RepRapLtd/FrankTheRobot/README.md

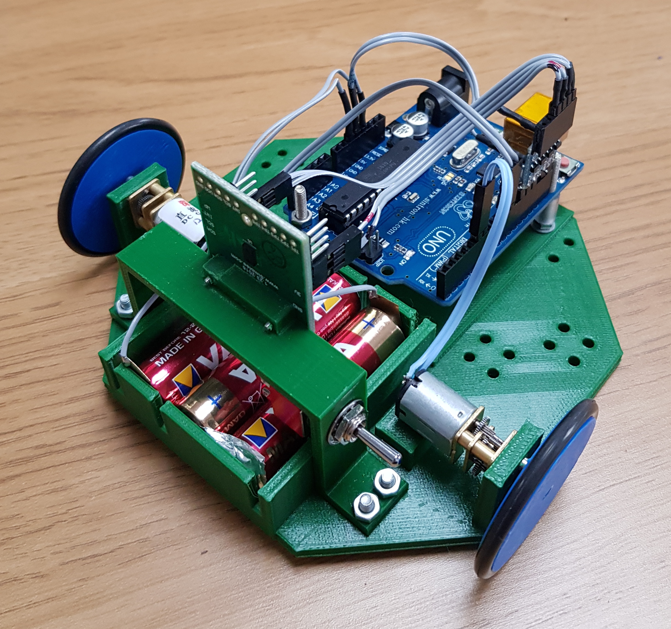
[picture p1: Pictures/frank.jpg]
Frank The Robot


This is a small robot for testing out LIDAR scanning rangefinders, automatic environment mapping, 21st century Grey-Walter tortoise like behaviour etc.
