RepRapLtd/FrankTheRobot/Electronics/pinouts.ods

GPIO 0 | ground to program
GPIO 2 | 10K pullup
GPIO 15 | 10K pulldown
 | Frank | D1 MINI | D1 MINI
 | A select | D0 | GPIO 16
 | SCL (LIDAR) | D1 | GPIO 5
 | SDA (LIDAR) | D2 | GPIO 4
 | right FIN | D3 | GPIO 0*
 | right RIN | D4 | GPIO 2*
 | left FIN | D8 | GPIO 15*
 | left RIN | D6 | GPIO 12
 | right SENSE | D7 | GPIO 13
 | left SENSE | D5 | GPIO 14
 | Analog in | A0 | ADC
