RepRapLtd/FrankTheRobot/Frank 2.0/Electronics/board-back.png

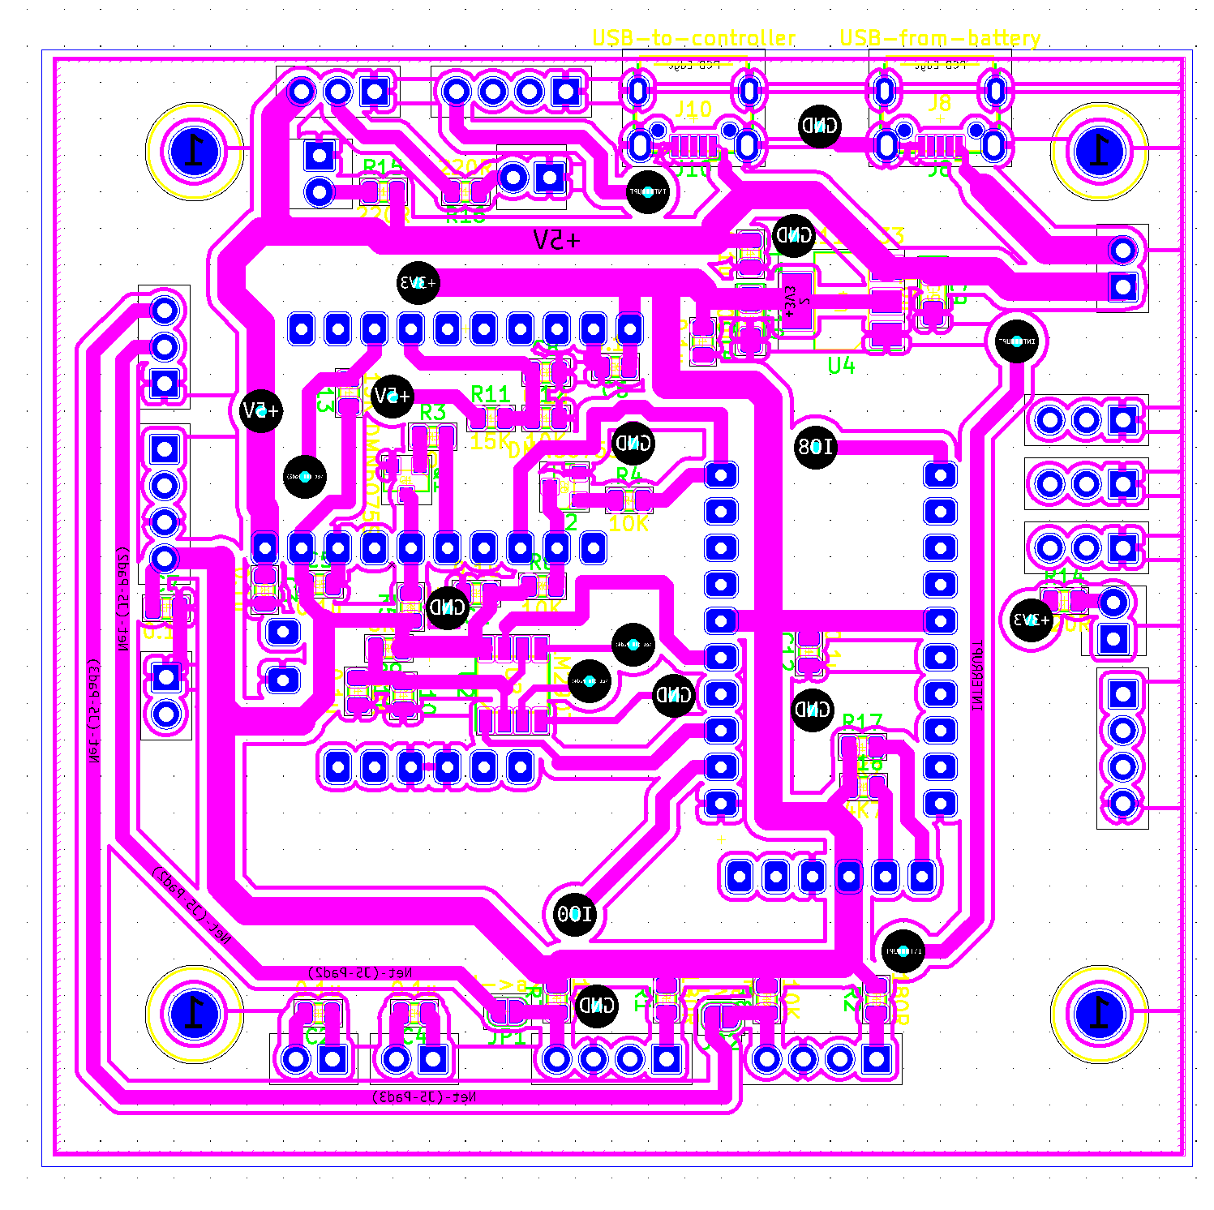
Frank 2.0/Electronics/board-back.png
