RepRapLtd/FrankTheRobot/Frank 2.0/Electronics/GPIO-Pinout-Diagram-2.png

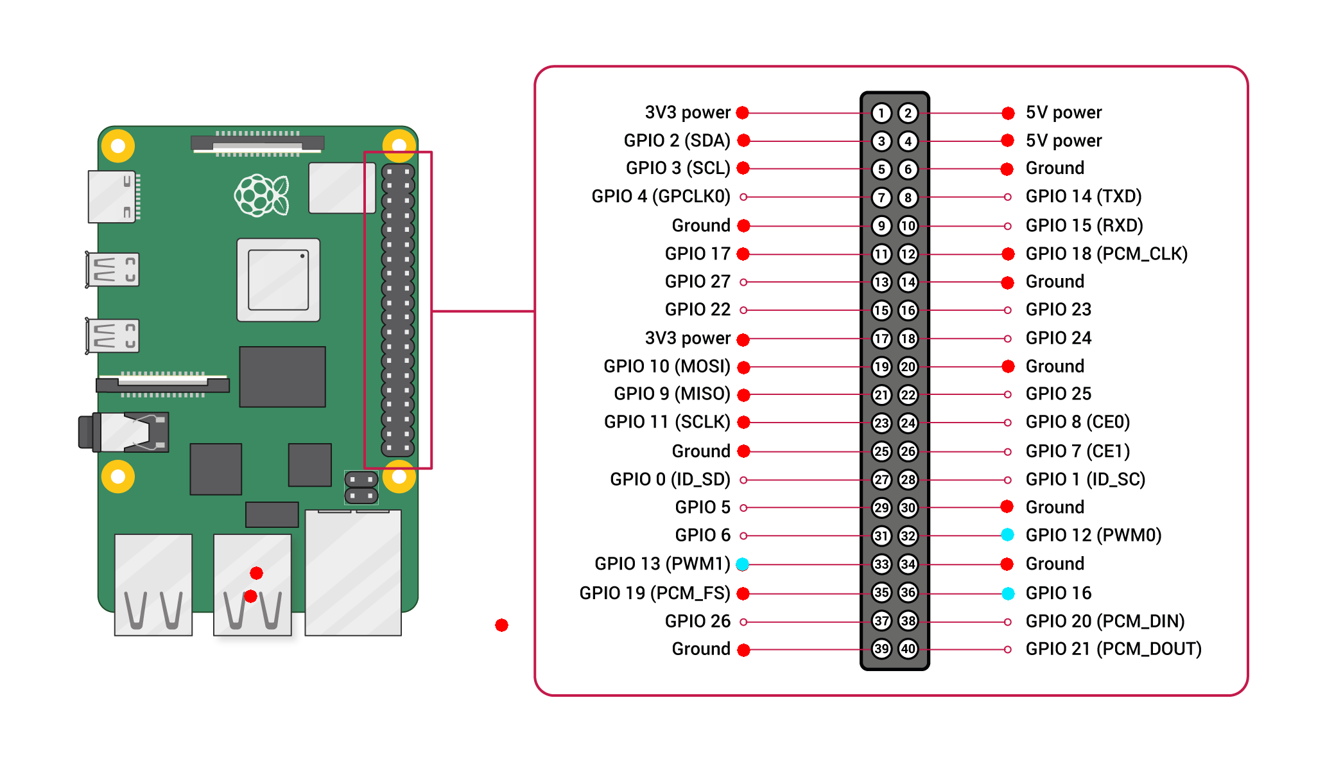
Frank 2.0/Electronics/GPIO-Pinout-Diagram-2.png
