RepRapLtd/FrankTheRobot/Frank 2.0/Electronics/schematic.png

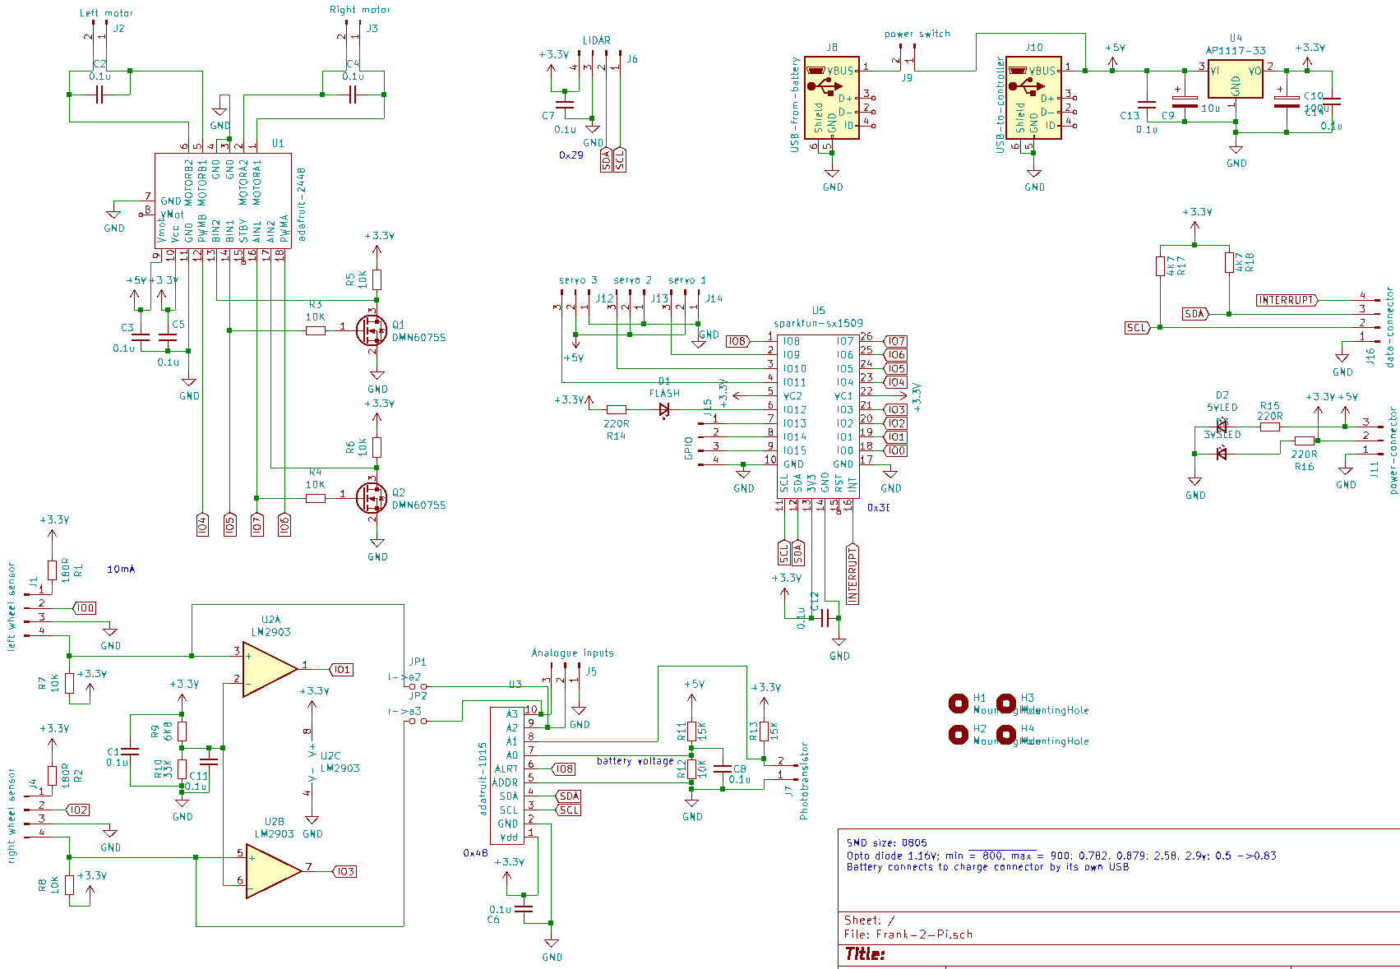
Frank 2.0/Electronics/schematic.png
