RepRapLtd/FrankTheRobot/Mechanics/STLs/5028.4 Frank Main Body.stl

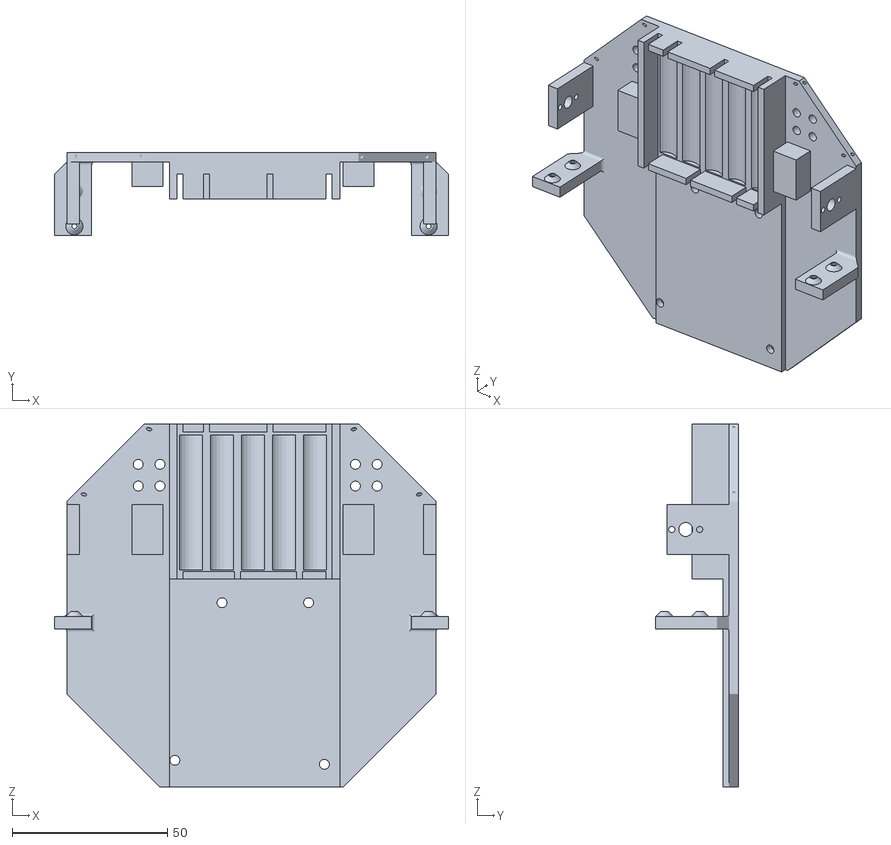
[picture p6: CAD file, 2018-05-11]
Mechanics/STLs/5028.4 Frank Main Body.stl
127.0 x 26.8 x 117.0
