RepRapLtd/FrankTheRobot/Mechanics/STLs/5028.2 Main body.stl

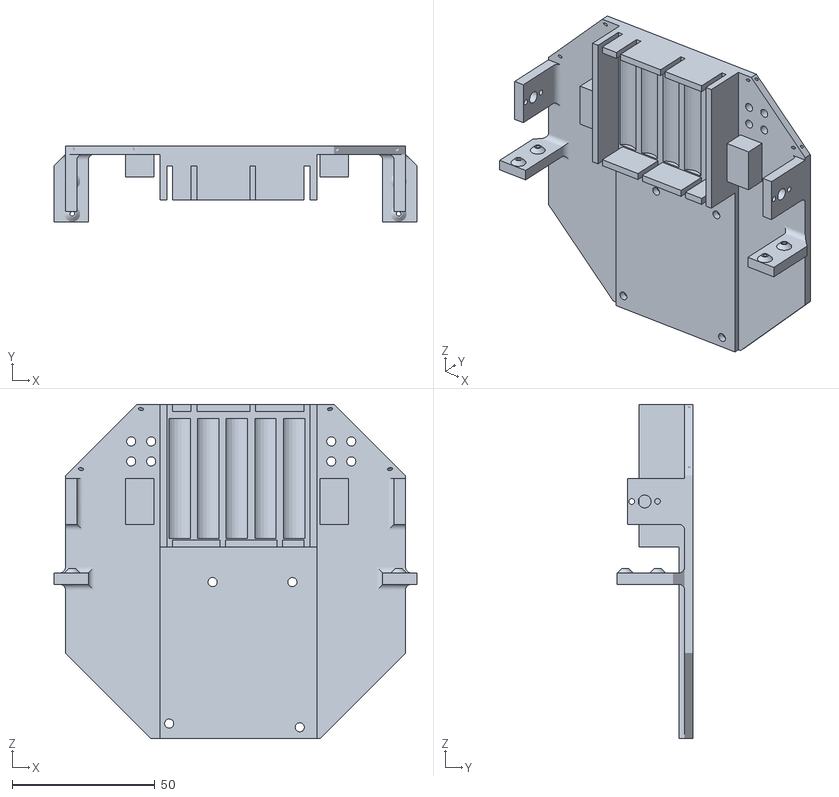
[picture p7: CAD file, 2018-02-01]
Mechanics/STLs/5028.2 Main body.stl
127.0 x 26.8 x 117.0
