RepRapLtd/FrankTheRobot/Frank 2.0/Mechanics/Battery Charge Indicator Clip.FCStd

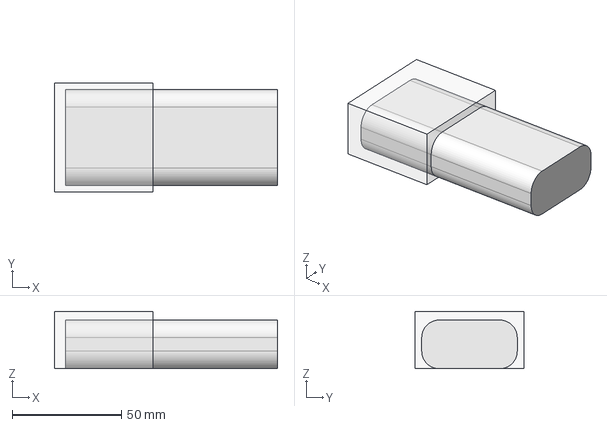
[picture p8: CAD file, 2021-03-25]
Frank 2.0/Mechanics/Battery Charge Indicator Clip.FCStd
102.0 x 50.0 x 26.3 mm
