RepRapLtd/FrankTheRobot/Mechanics/5028.7 Frank.fcstd

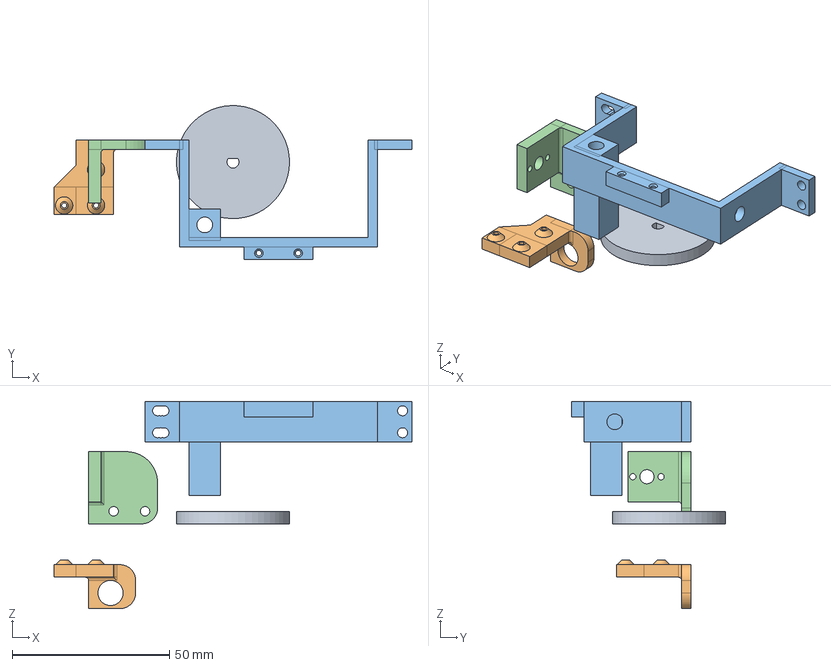
[picture p9: CAD file, 2020-05-19]
Mechanics/5028.7 Frank.fcstd
114.0 x 49.0 x 66.0 mm
Wheel Sensor Mount
Switch Mount
Motor Mount
