RepRapLtd/FrankTheRobot/Mechanics/STLs/5029.8 Power Dock Mount.stl

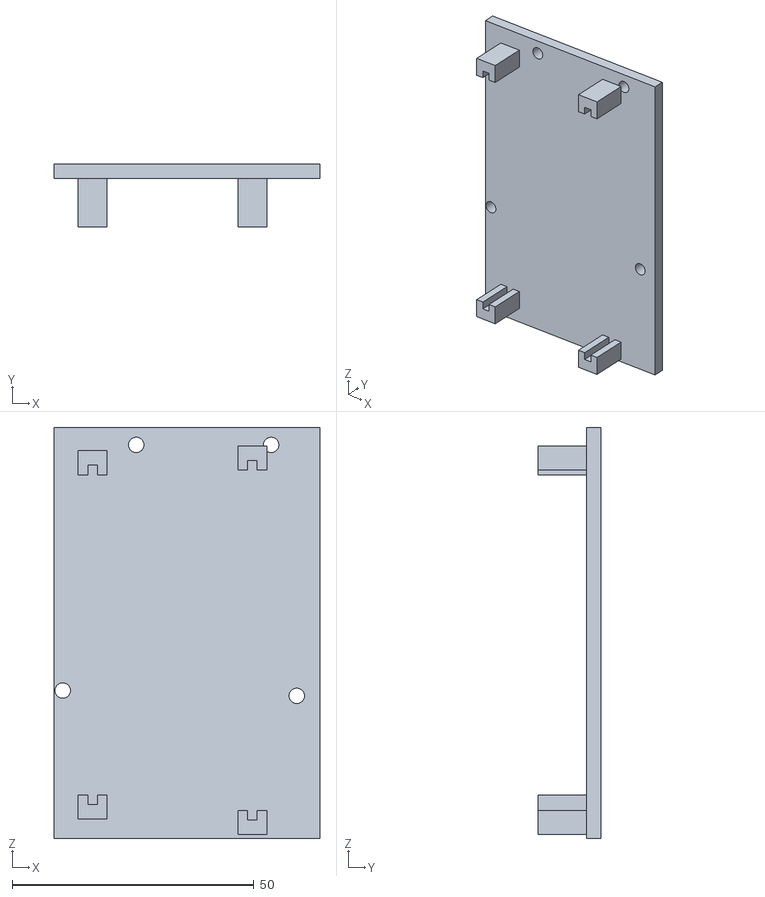
[picture p10: CAD file, 2020-05-19]
Mechanics/STLs/5029.8 Power Dock Mount.stl
55.0 x 13.0 x 85.0
