RepRapLtd/FrankTheRobot/Frank 2.0/Mechanics/Motor and Opto Sensor Mount0.5.FCStd

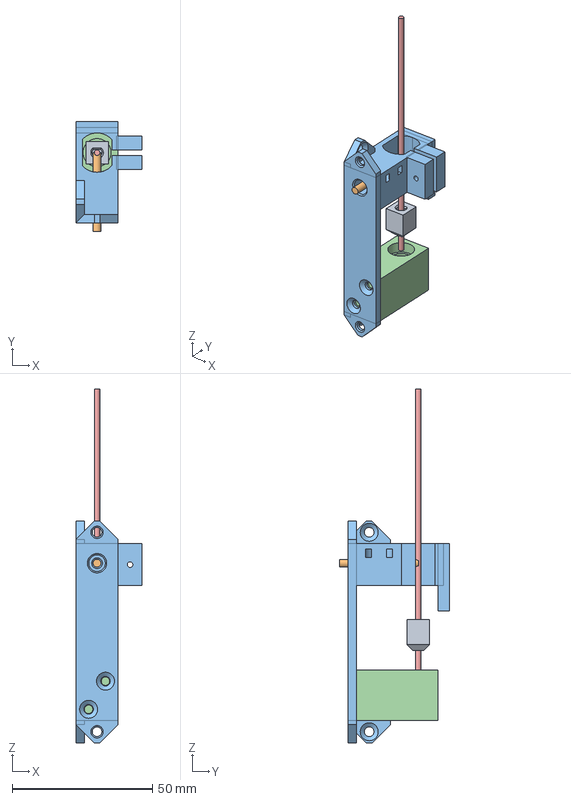
[picture p11: CAD file, 2020-09-02]
Frank 2.0/Mechanics/Motor and Opto Sensor Mount0.5.FCStd
23.5 x 39.0 x 126.0 mm
Square Peg 0.3
Motor and Opto Sensor Mount 0.4
Bearing Mount End 0.5
