RepRapLtd/FrankTheRobot/Mechanics/5029.8 Frank Power Dock .fcstd

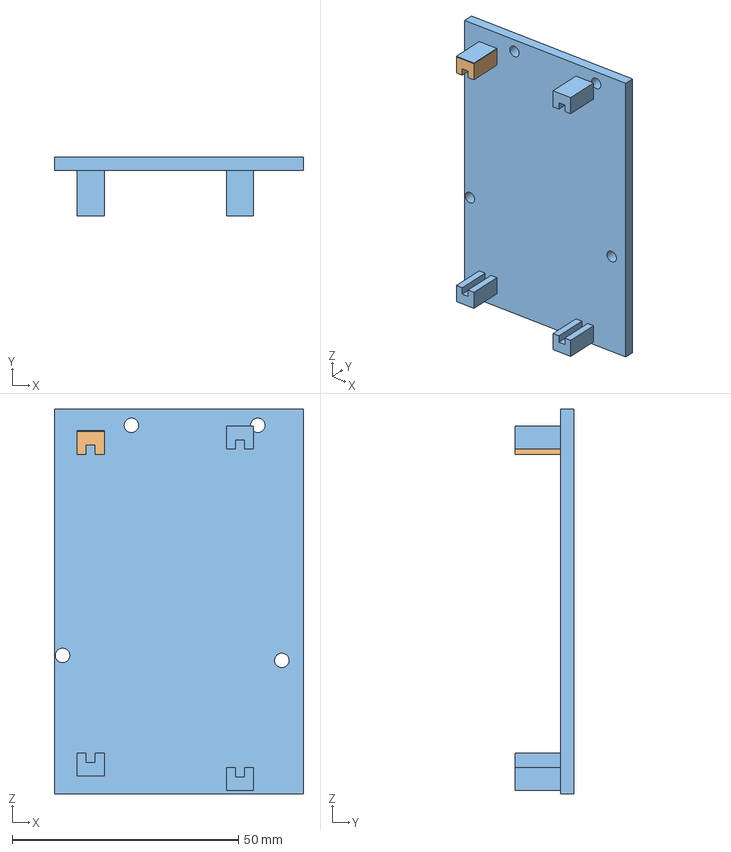
[picture p12: CAD file, 2020-05-19]
Mechanics/5029.8 Frank Power Dock .fcstd
55.0 x 13.0 x 85.0 mm
