RepRapLtd/FrankTheRobot/Mechanics/STLs/Wheel1.57 2019.stl

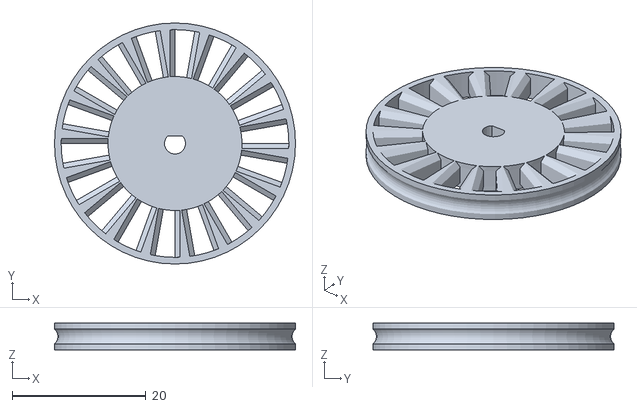
[picture p13: CAD file, 2020-05-19]
Mechanics/STLs/Wheel1.57 2019.stl
36.0 x 36.0 x 4.00
