RepRapLtd/FrankTheRobot/Frank 2.0/Mechanics/Square Peg 0.3.stl

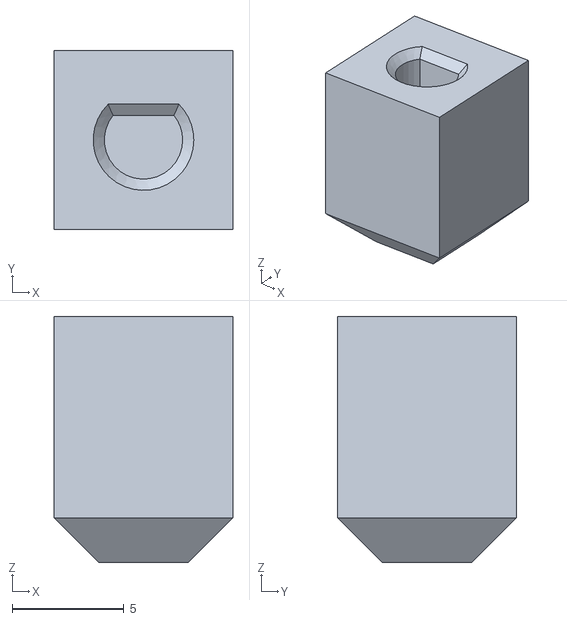
[picture p14: CAD file, 2020-09-02]
Frank 2.0/Mechanics/Square Peg 0.3.stl
8.00 x 8.00 x 11.0
