RepRapLtd/FrankTheRobot/Mechanics/STLs/5028.7 Wheel Sensor Mount.stl

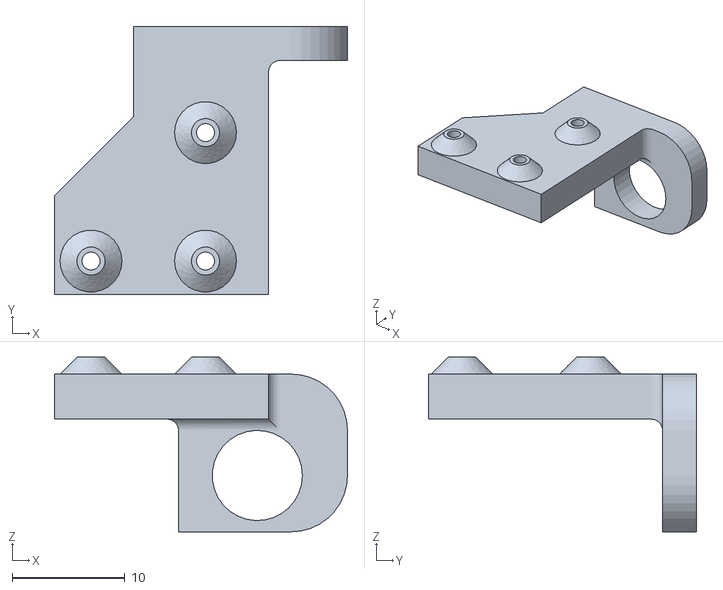
[picture p15: CAD file, 2019-01-25]
Mechanics/STLs/5028.7 Wheel Sensor Mount.stl
26.0 x 23.8 x 15.5
