RepRapLtd/FrankTheRobot/Frank 2.0/Mechanics/Bearing Mount End 0.5.stl

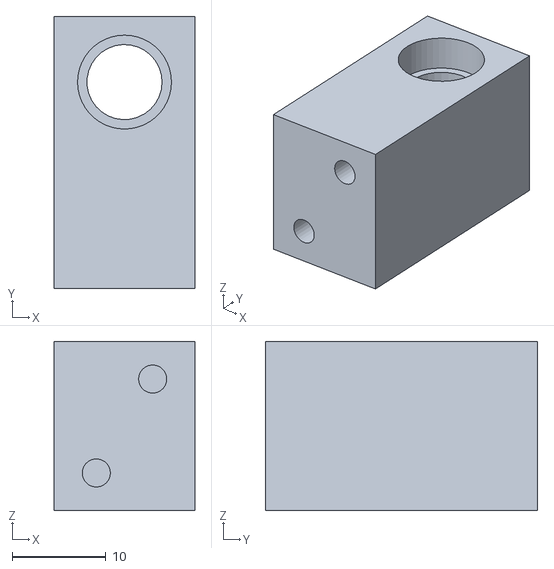
[picture p16: CAD file, 2020-08-12]
Frank 2.0/Mechanics/Bearing Mount End 0.5.stl
15.0 x 29.0 x 18.0
