RepRapLtd/FrankTheRobot/Mechanics/5028.7 Blank Frank.fcstd

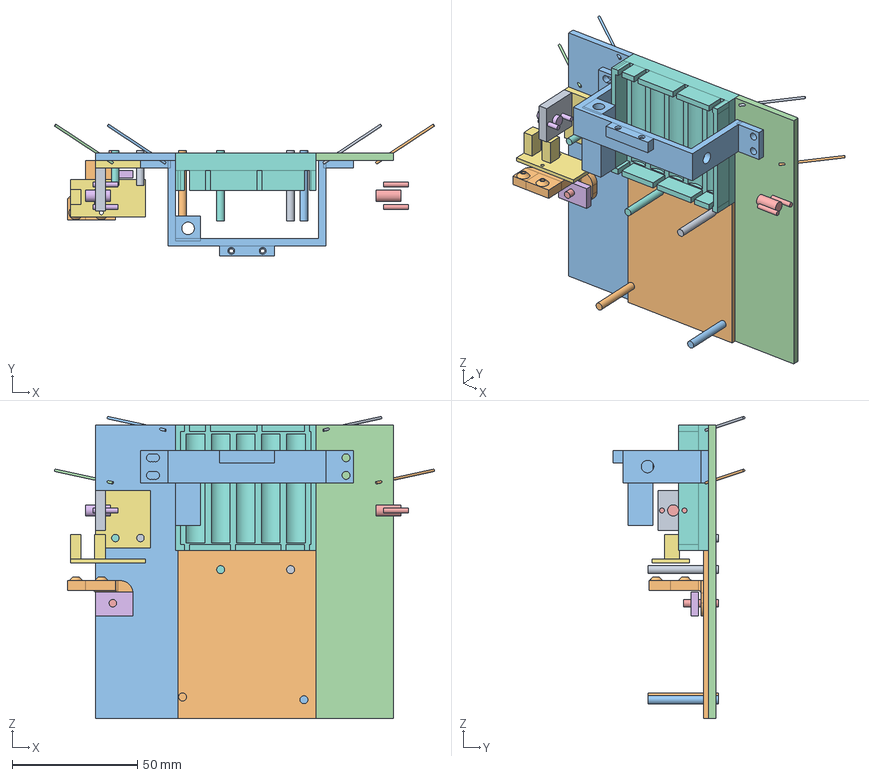
[picture p17: CAD file, 2018-06-24]
Mechanics/5028.7 Blank Frank.fcstd
151.6 x 52.6 x 120.5 mm
Motor Mount Right
Cube014 Arduino Support cube
Motor Holes Left
Motor Holes Right
Spoke Sensor PCB001
Arduino Cylinder191
Arduino Cylinder192
Arduino Cylinder193
Arduino Cylinder194
M3 Nut004
M3 Nut005
M3 Nut006
M3 Nut007
BAtt Holder
Cylinder211 (Mirror #13)
Cylinder212 (Mirror #14)
Printed Washer
