RepRapLtd/FrankTheRobot/Mechanics/STLs/5028.7 Chamfer Wheel.stl

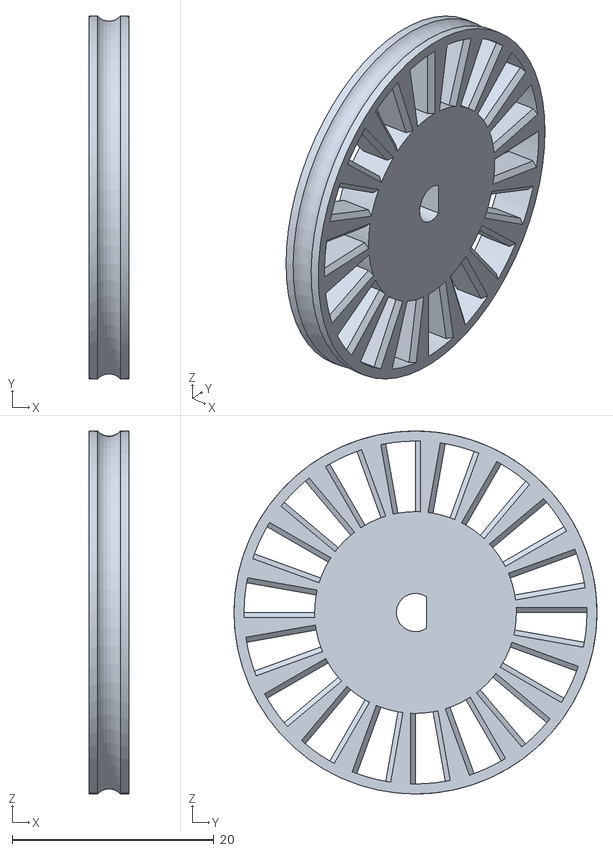
[picture p18: CAD file, 2019-01-25]
Mechanics/STLs/5028.7 Chamfer Wheel.stl
4.00 x 36.0 x 36.0
