RepRapLtd/FrankTheRobot/Frank 2.0/Mechanics/Castor 0.2.FCStd

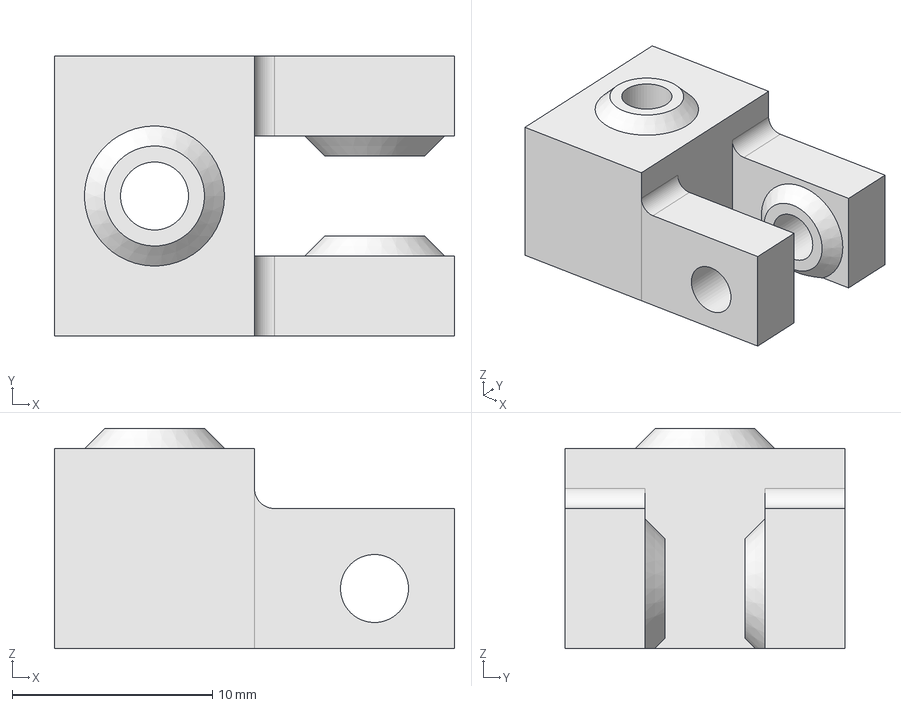
[picture p19: CAD file, 2020-08-12]
Frank 2.0/Mechanics/Castor 0.2.FCStd
20.0 x 14.0 x 11.0 mm
