RepRapLtd/FrankTheRobot/Mechanics/5028.6 Blank Frank.fcstd

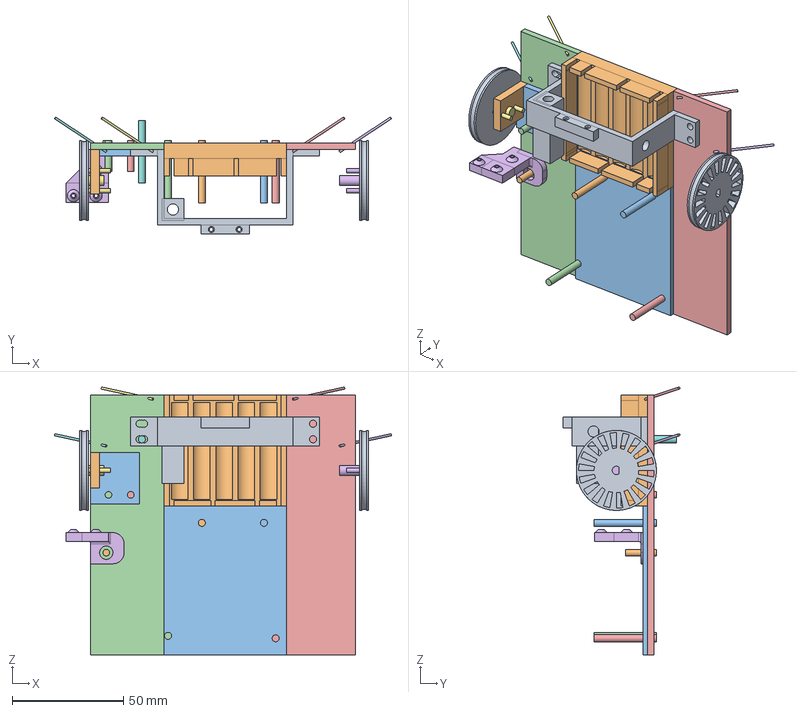
[picture p20: CAD file, 2018-06-08]
Mechanics/5028.6 Blank Frank.fcstd
151.6 x 52.6 x 120.5 mm
wheel1
Motor Mount Right
Cube014 Arduino Support cube
Motor Holes Left
Motor Holes Right
Wheel with Spokes AB
Arduino Cylinder191
Arduino Cylinder192
Arduino Cylinder193
Arduino Cylinder194
M3 Nut004
M3 Nut005
M3 Nut006
M3 Nut007
BAtt Holder
Cylinder211 (Mirror #13)
Cylinder212 (Mirror #14)
Switch Mount
