RepRapLtd/FrankTheRobot/Mechanics/STLs/5028.7 Motor Mount.stl

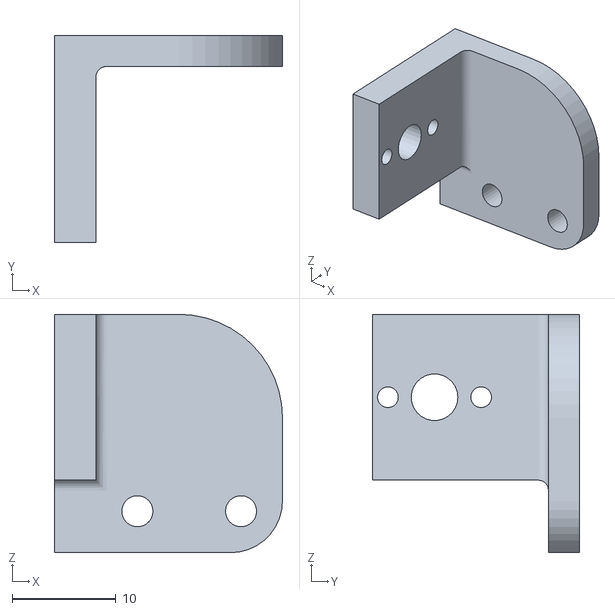
[picture p21: CAD file, 2019-01-25]
Mechanics/STLs/5028.7 Motor Mount.stl
22.0 x 20.0 x 23.0
