RepRapLtd/FrankTheRobot/Mechanics/wheel 1.6 hole.fcstd

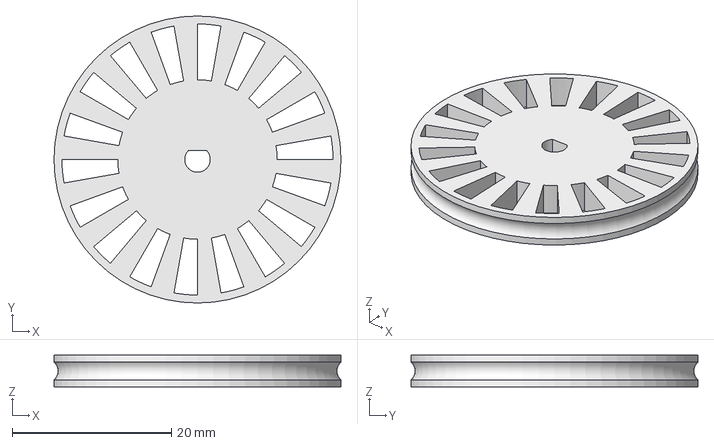
[picture p22: CAD file, 2018-06-08]
Mechanics/wheel 1.6 hole.fcstd
36.0 x 36.0 x 4.00 mm
