RepRapLtd/FrankTheRobot/Mechanics/STLs/5028.7 mount.stl

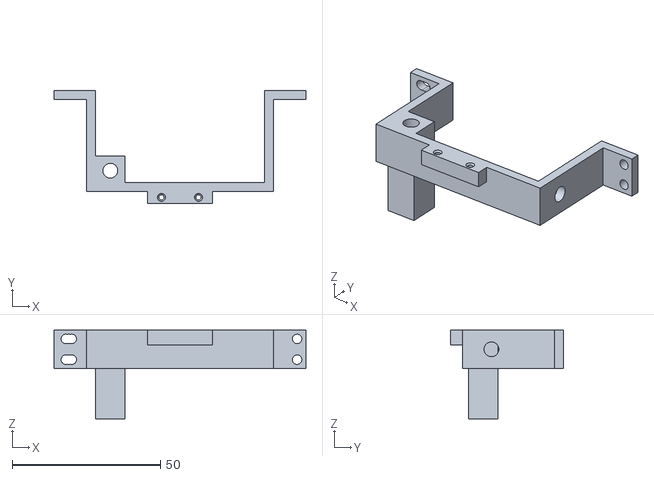
[picture p23: CAD file, 2018-06-20]
Mechanics/STLs/5028.7 mount.stl
85.0 x 38.0 x 30.0
