RepRapLtd/FrankTheRobot/Frank 2.0/Mechanics/Wheel 0.4.stl

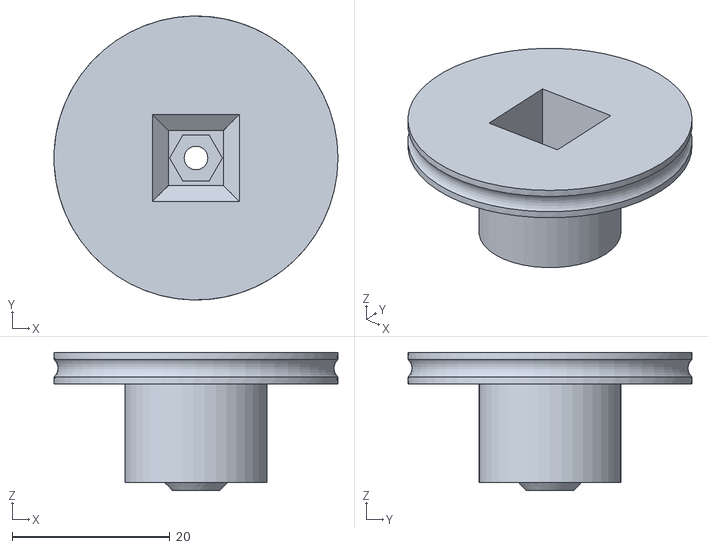
[picture p24: CAD file, 2020-07-30]
Frank 2.0/Mechanics/Wheel 0.4.stl
36.0 x 36.0 x 17.5
