RepRapLtd/FrankTheRobot/Mechanics/STLs/5028.7 Batt Holder.stl

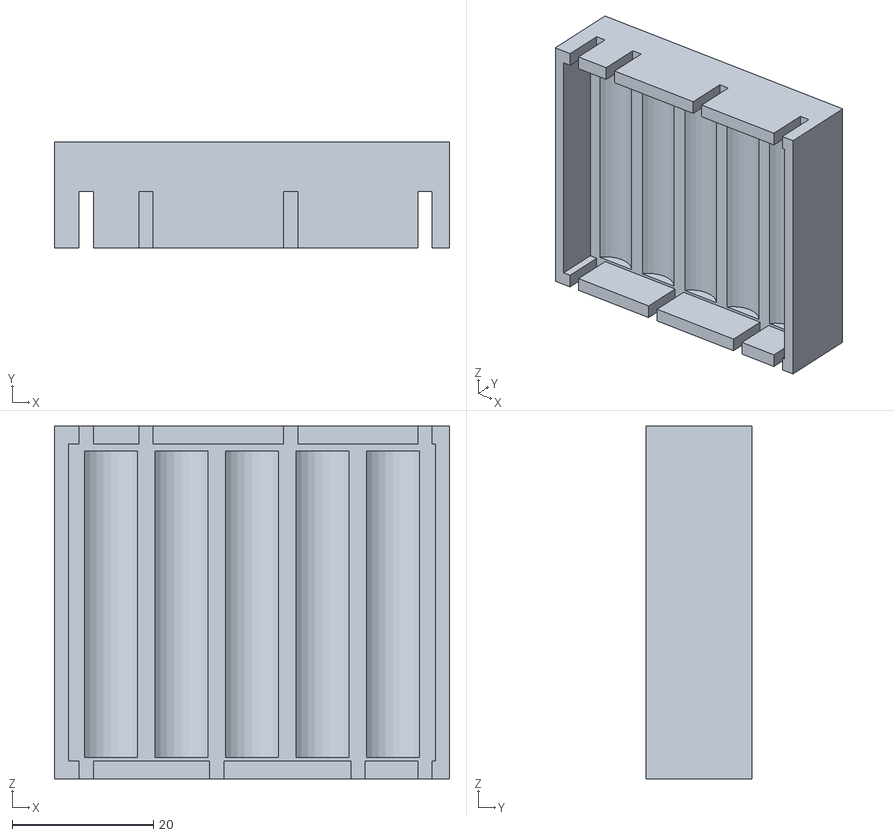
[picture p25: CAD file, 2018-06-20]
Mechanics/STLs/5028.7 Batt Holder.stl
56.0 x 15.0 x 50.0
