RepRapLtd/FrankTheRobot/Mechanics/wheel.fcstd

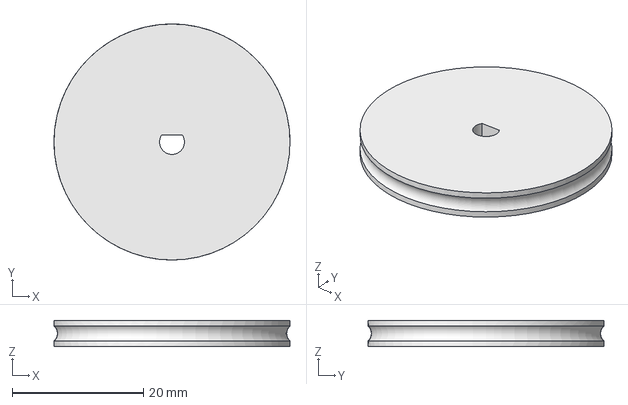
[picture p26: CAD file, 2018-06-08]
Mechanics/wheel.fcstd
36.0 x 36.0 x 4.00 mm
