RepRapLtd/FrankTheRobot/Mechanics/STLs/5028.6 Body.stl

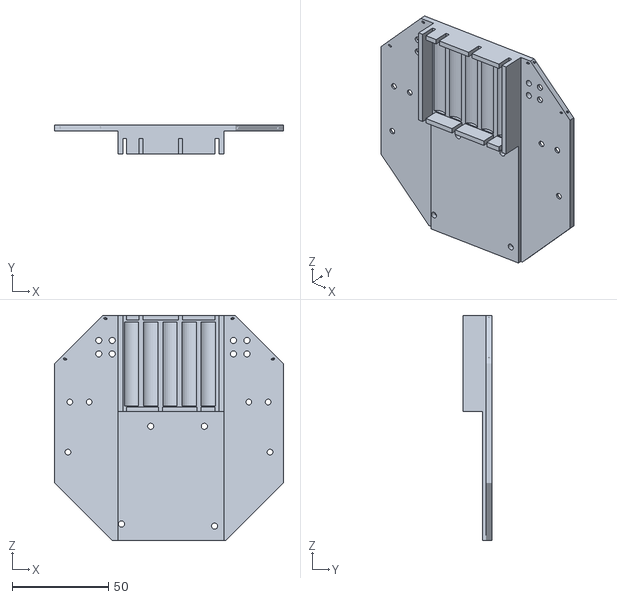
[picture p28: CAD file, 2018-06-08]
Mechanics/STLs/5028.6 Body.stl
119.0 x 15.0 x 117.0
