RepRapLtd/FrankTheRobot/Mechanics/5028.6 Frank.fcstd

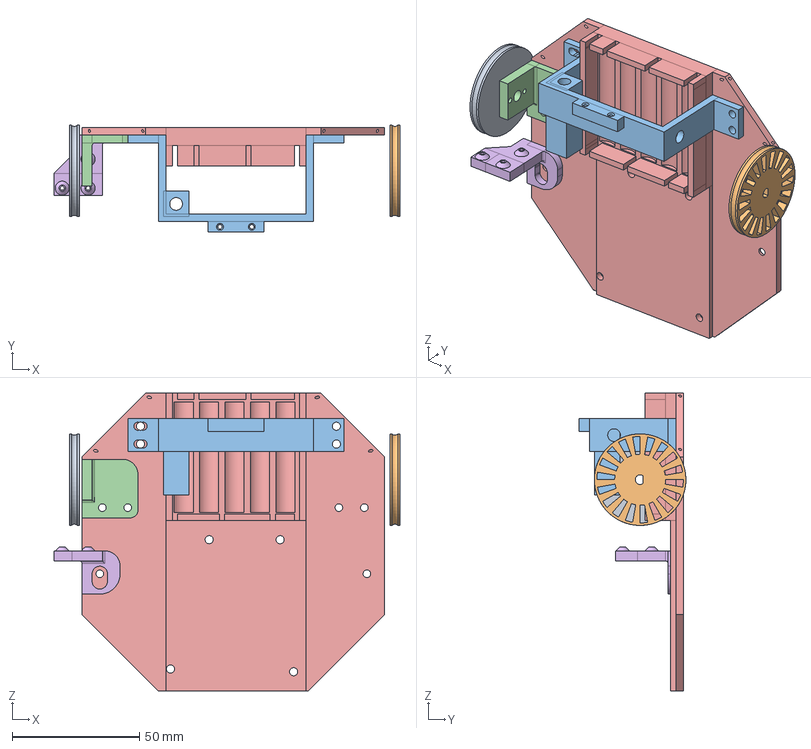
[picture p29: CAD file, 2018-06-08]
Mechanics/5028.6 Frank.fcstd
136.0 x 42.0 x 117.0 mm
wheel1
Wheel with Spokes AB
Switch Mount
Wheel Mount003
Sensor Mount
