RepRapLtd/FrankTheRobot/Frank 2.0/Mechanics/Motor and Opto Sensor Mount0.4.FCStd

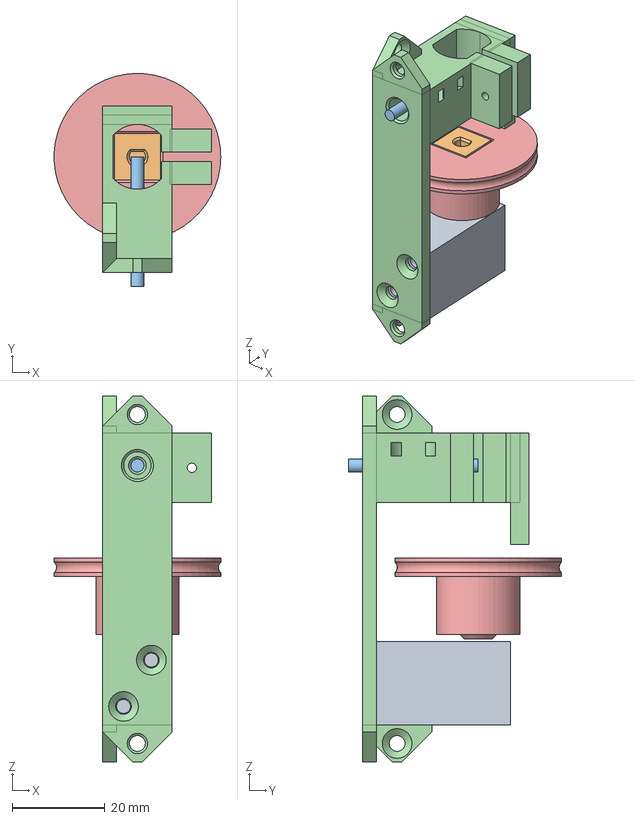
[picture p30: CAD file, 2020-07-30]
Frank 2.0/Mechanics/Motor and Opto Sensor Mount0.4.FCStd
36.0 x 46.0 x 79.0 mm
Bearing Mount End 0.2
Square Peg 0.2
Motor and Opto Sensor Mount 0.4
Wheel 0.4
