RepRapLtd/FrankTheRobot/Mechanics/5028.4 Blank Frank.fcstd

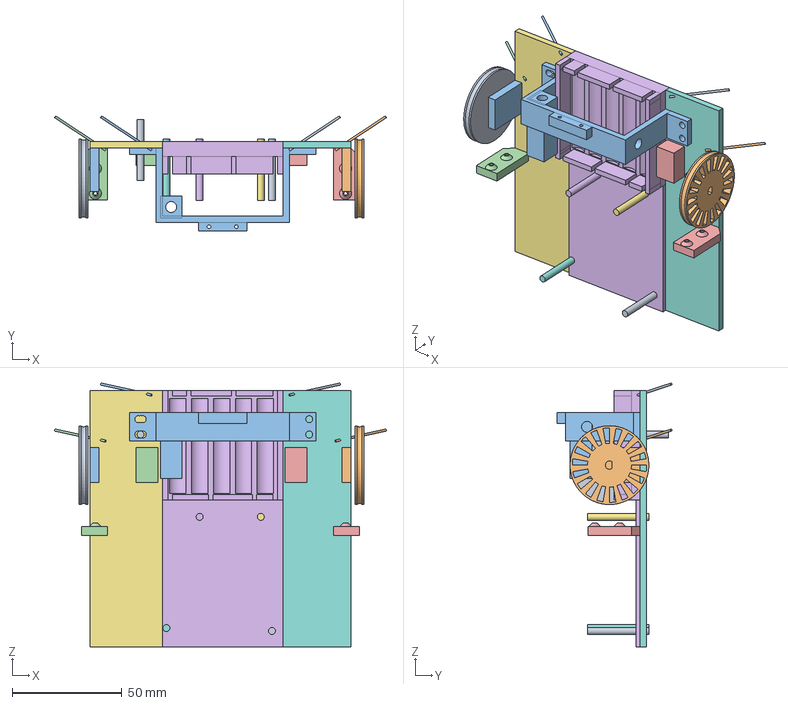
[picture p31: CAD file, 2018-05-11]
Mechanics/5028.4 Blank Frank.fcstd
151.6 x 52.6 x 120.5 mm
wheel1
Motor Mount Left
Motor Mount Right
Motor Support Right
Motor Support Left
Cube014 Arduino Support cube
Wheel with Spokes AB
Switch Mount with phototransistor hole
Cut045028 (Mirror #6)
Arduino Cylinder191
Arduino Cylinder192
Arduino Cylinder193
Arduino Cylinder194
M3 Nut004
M3 Nut005
M3 Nut006
M3 Nut007
BAtt Holder
Cylinder211 (Mirror #13)
Cylinder212 (Mirror #14)
