RepRapLtd/FrankTheRobot/Mechanics/5028.3 Frank the Robot.fcstd

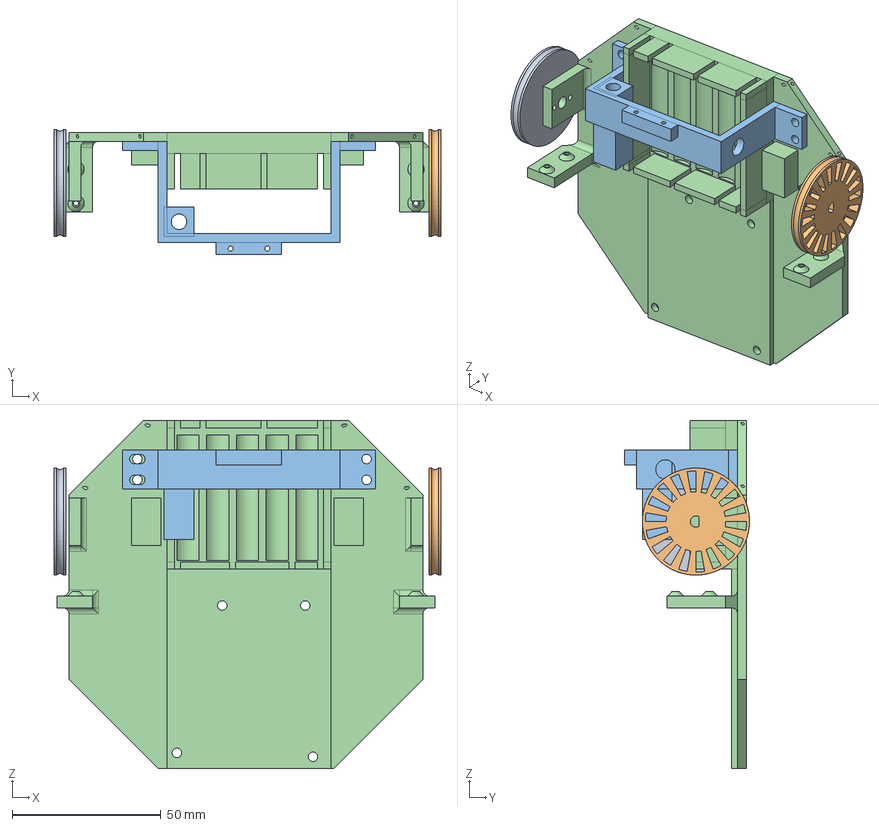
[picture p33: CAD file, 2018-05-11]
Mechanics/5028.3 Frank the Robot.fcstd
130.0 x 42.0 x 117.0 mm
wheel1
Wheel with Spokes AB
Switch Mount with phototransistor hole
