RepRapLtd/FrankTheRobot/Frank 2.0/Mechanics/Square Peg 0.1.stl

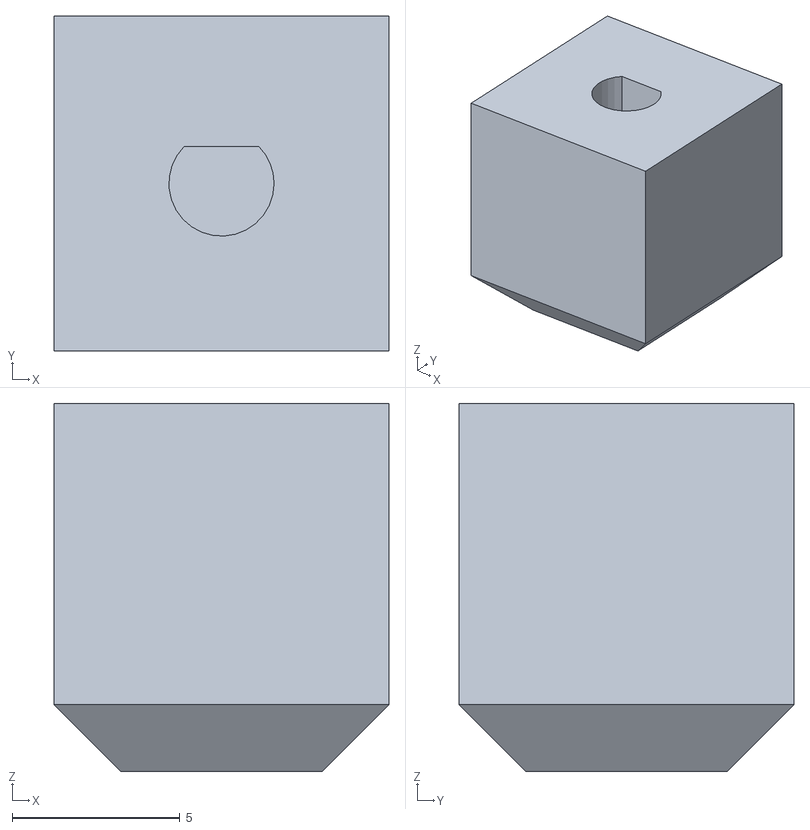
[picture p34: CAD file, 2020-07-03]
Frank 2.0/Mechanics/Square Peg 0.1.stl
10.0 x 10.0 x 11.0
