RepRapLtd/FrankTheRobot/Mechanics/5028.4 Frank.fcstd

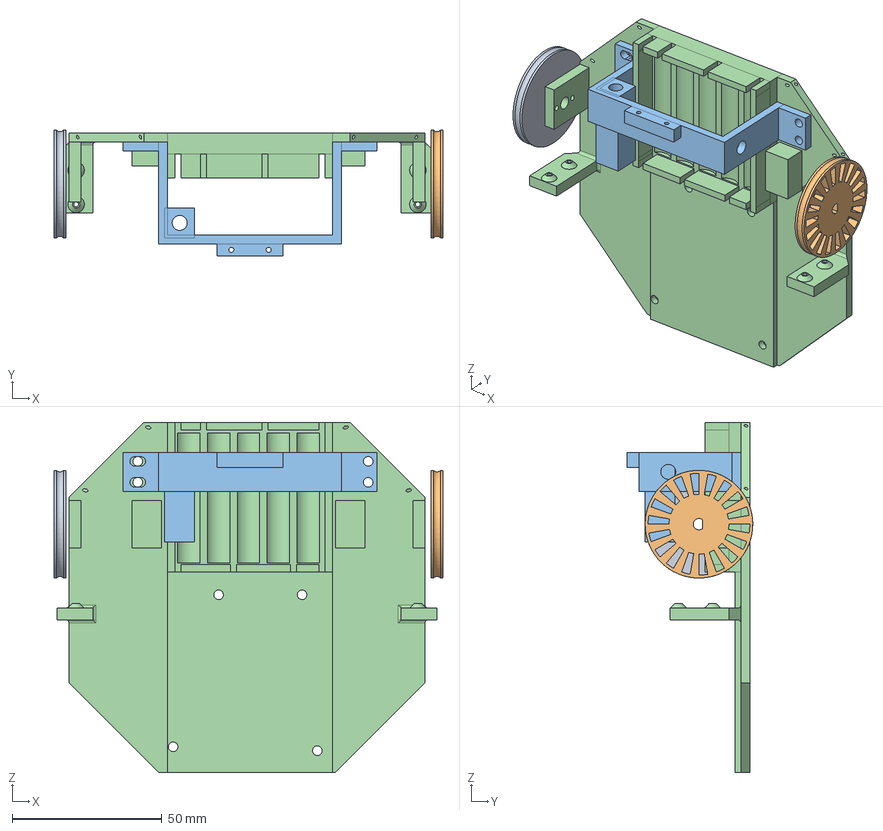
[picture p35: CAD file, 2018-05-11]
Mechanics/5028.4 Frank.fcstd
130.0 x 42.0 x 117.0 mm
wheel1
Wheel with Spokes AB
Switch Mount with phototransistor hole
Frank Main Body
