RepRapLtd/FrankTheRobot/Frank 2.0/Mechanics/Motor and Opto Sensor Mount0.1.FCStd

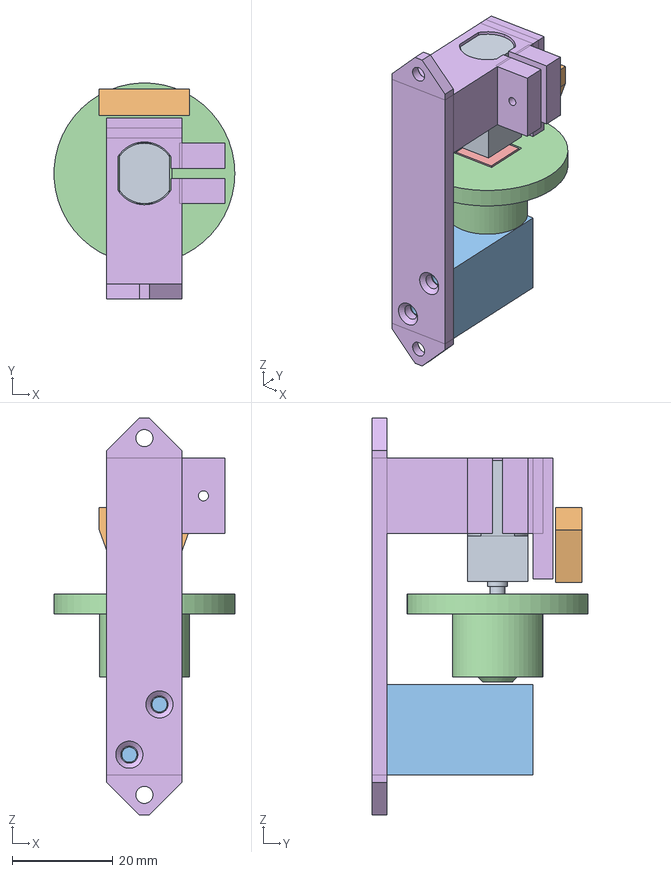
[picture p36: CAD file, 2020-07-03]
Frank 2.0/Mechanics/Motor and Opto Sensor Mount0.1.FCStd
36.0 x 43.0 x 79.0 mm
motor-assembled
Opto Sensor
Bearing Mount End
Wheel
Square Peg001
