RepRapLtd/FrankTheRobot/Mechanics/5028.2 Frank the Robot.fcstd

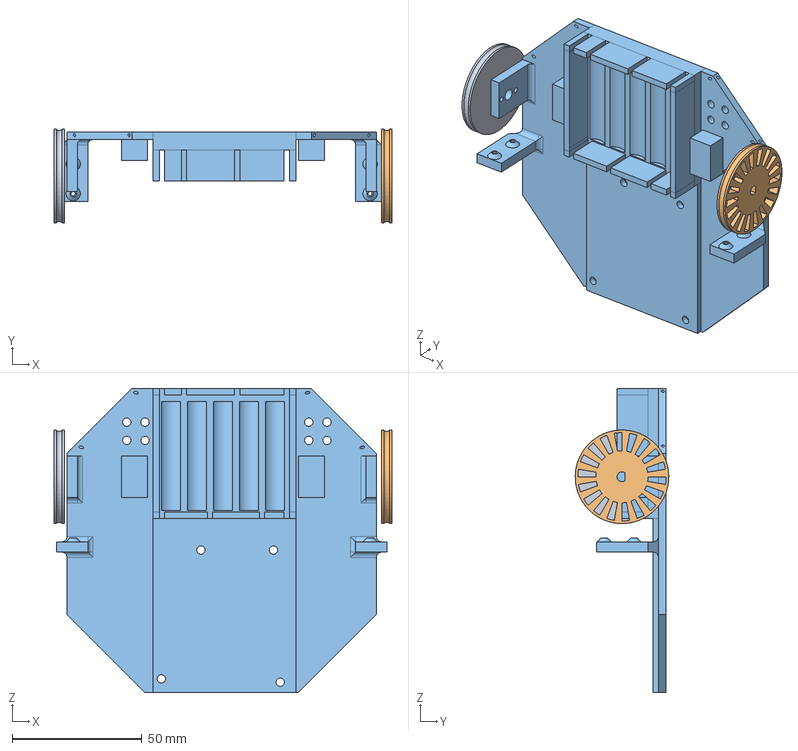
[picture p37: CAD file, 2018-02-01]
Mechanics/5028.2 Frank the Robot.fcstd
130.0 x 36.0 x 117.0 mm
wheel1
Wheel with Spokes AB
