RepRapLtd/FrankTheRobot/Frank 2.0/Mechanics/wheel-profile-2.dxf

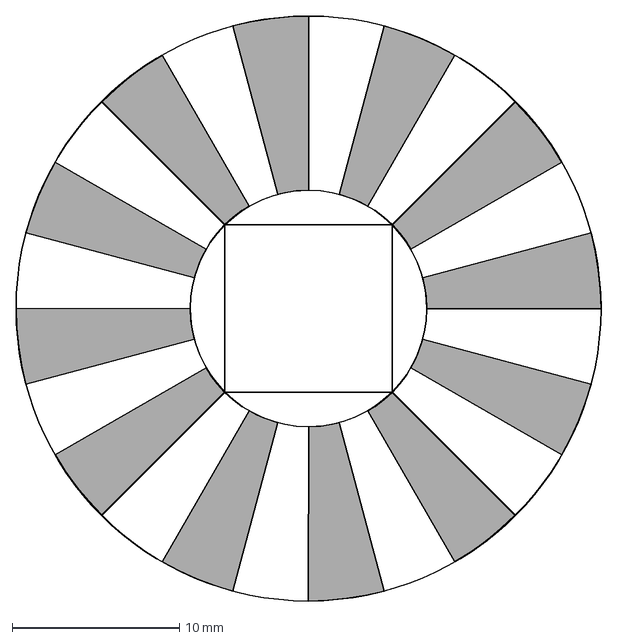
[picture p38: CAD file, 2020-07-03]
Frank 2.0/Mechanics/wheel-profile-2.dxf
35.0 x 35.0 mm
