RepRapLtd/FrankTheRobot/Mechanics/5028.2 Blank Frank the Robot.fcstd

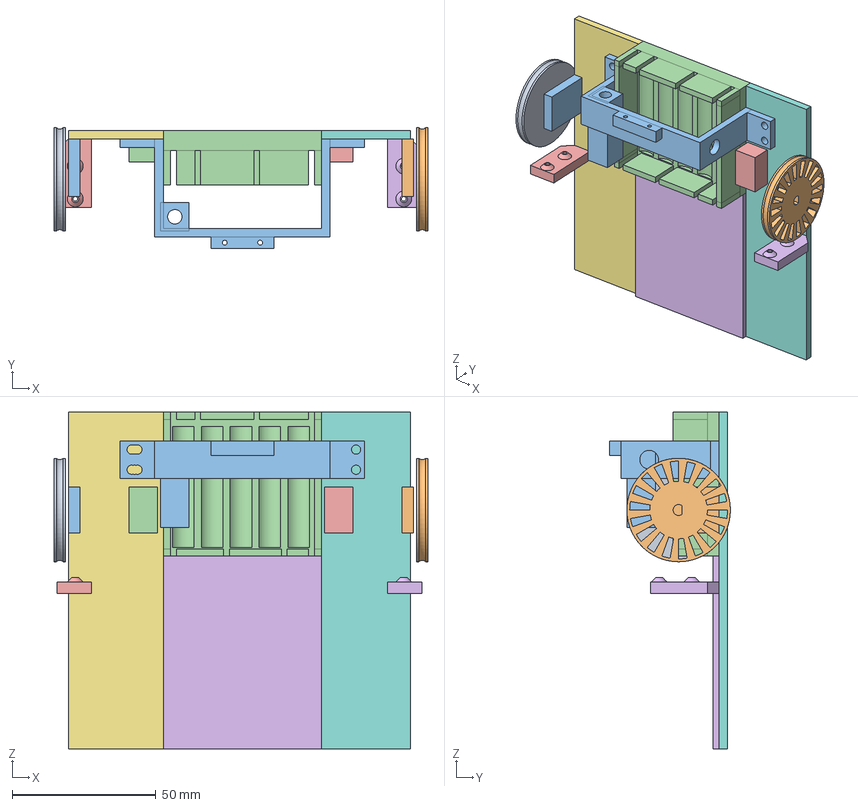
[picture p39: CAD file, 2018-02-01]
Mechanics/5028.2 Blank Frank the Robot.fcstd
130.0 x 42.0 x 117.0 mm
wheel1
Motor Mount Left
Motor Mount Right
Motor Support Right
Motor Support Left
Cube014 Arduino Support cube
Hex Holes
Wheel with Spokes AB
Switch Mount with phototransistor hole
Cut045028 (Mirror #6)
