RepRapLtd/FrankTheRobot/Mechanics/STLs/5028.6 Sensor Mount.stl

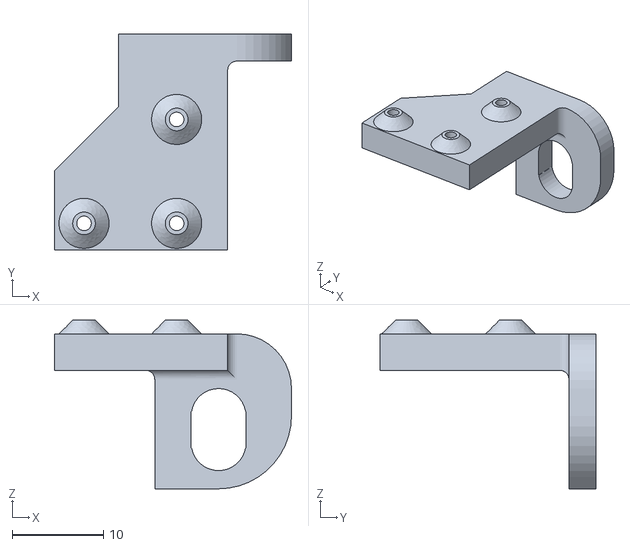
[picture p40: CAD file, 2018-06-08]
Mechanics/STLs/5028.6 Sensor Mount.stl
26.0 x 23.8 x 18.5
