RepRapLtd/FrankTheRobot/Frank 2.0/Mechanics/wheel-profile.dxf

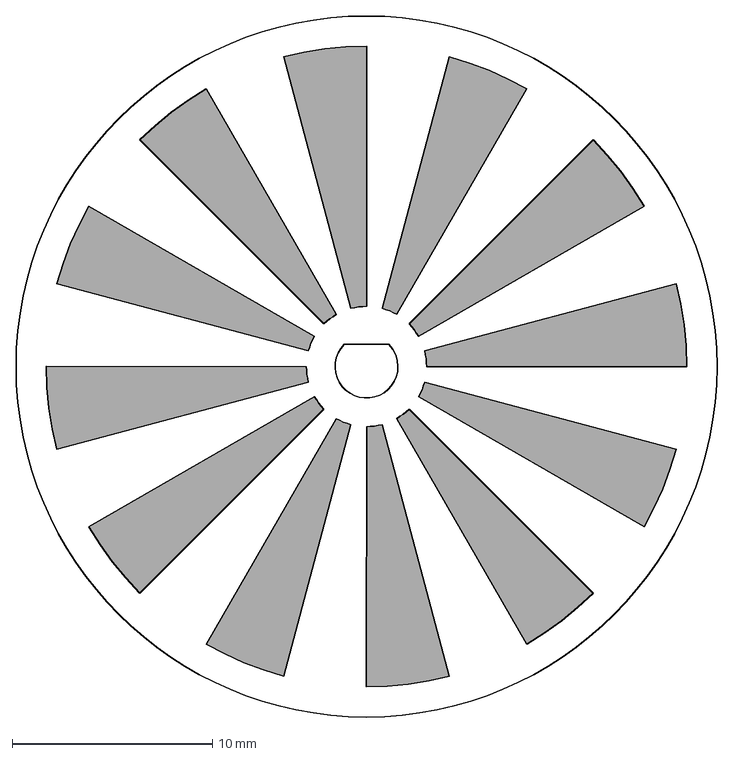
[picture p42: CAD file, 2020-05-19]
Frank 2.0/Mechanics/wheel-profile.dxf
35.0 x 35.0 mm
