RepRapLtd/FrankTheRobot/Mechanics/5028.1 Frank the Robot.fcstd

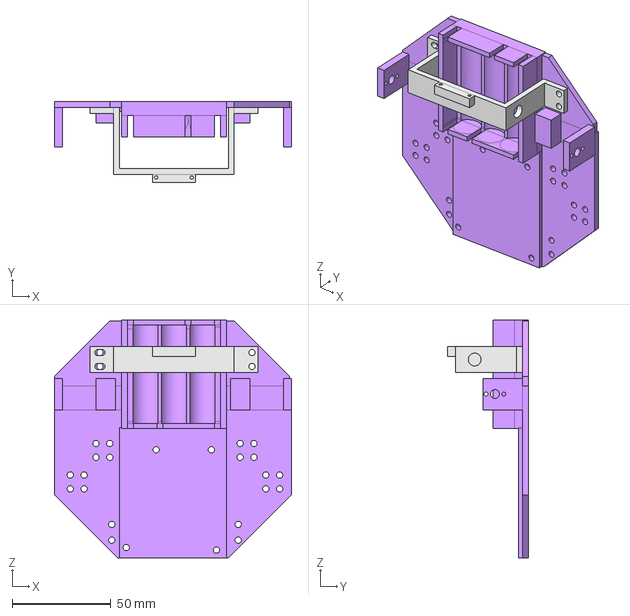
[picture p43: CAD file, 2017-12-18]
Mechanics/5028.1 Frank the Robot.fcstd
120.0 x 41.0 x 120.5 mm
Switch Bracket001
