RepRapLtd/FrankTheRobot/Mechanics/STLs/5028.1 Switch Bracket.stl

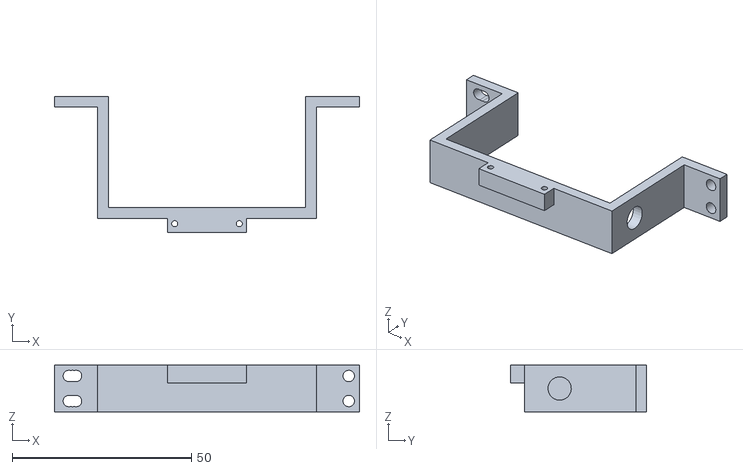
[picture p44: CAD file, 2017-12-18]
Mechanics/STLs/5028.1 Switch Bracket.stl
85.0 x 38.0 x 13.0
