RepRapLtd/FrankTheRobot/(list of files, cad)

Other CAD files:
Mechanics/wheel 1.57 hole.fcstd
Mechanics/STLs/5028.7 Chamfer Wheel0.75 .stl
Frank 2.0/Mechanics/Castor 0.3.FCStd
Frank 2.0/Mechanics/Castor 0.1.FCStd
Mechanics/wheel 1.57 holeNo chamfer.fcstd
Mechanics/wheel 1.75 hole.fcstd
Frank 2.0/Mechanics/Bearing Mount End 0.2.stl
Mechanics/STLs/wheel 1.57.stl
Mechanics/STLs/5028.6 Wheel Mount Mirror.stl
Frank 2.0/Mechanics/Bearing Mount End 0.1.stl
Mechanics/5028.5 Blank Frank.fcstd
Mechanics/STLs/wheel 1.6.stl
Mechanics/STLs/wheel 1.75.stl
Mechanics/STLs/5028.6 Wheel Mount.stl
Mechanics/STLs/5028.3 Switch mount.stl
Frank 2.0/Mechanics/Wheel 0.1.FCStd
Mechanics/STLs/Switch Mount with phototransistor hole.stl
Mechanics/STLs/5028.2 Wheel.stl
Frank 2.0/Mechanics/Castor 0.1.stl
Frank 2.0/Mechanics/Castor 0.2.stl
Frank 2.0/Mechanics/Castor 0.3.stl
Frank 2.0/Mechanics/Motor and Opto Sensor Mount 0.1.stl
Frank 2.0/Mechanics/Motor and Opto Sensor Mount 0.2.stl
Frank 2.0/Mechanics/Motor and Opto Sensor Mount 0.3.stl
Frank 2.0/Mechanics/Motor and Opto Sensor Mount 0.4.stl
Frank 2.0/Mechanics/Wheel 0.1.stl
Legacy/ABs-old-frank-stuff/lidar-mounting-screws.fcstd
Mechanics/STLs/5028.6 printed washer.stl
Mechanics/lidar-mounting-screws.fcstd
