RepRapLtd/FrankTheRobot/Frank 2.0/Experiments/motorA.ods

Forward rising curve:
 | F | B
PWM | RPM
0 | 0 | 0
17 | 0 | 0
34 | 0 | 0
51 | 0 | 0
68 | 0 | 0
85 | 3 | 3
102 | 5 | 5
119 | 7 | 7
136 | 9 | 9
153 | 11 | 11
170 | 12 | 12
187 | 15 | 15
204 | 16 | 16
221 | 18 | 19
238 | 20 | 21
255 | 23 | 23
255 | 22 | 22
238 | 21 | 21
221 | 19 | 19
204 | 17 | 17
187 | 15 | 15
170 | 13 | 13
153 | 11 | 11
136 | 9 | 9
119 | 8 | 8
102 | 6 | 6
85 | 4 | 4
68 | 3 | 2
51 | 0 | 0
34 | 0 | 0
17 | 0 | 0
0 | 0 | 0
Backward rising curve:
PWM | RPM
0 | 0
17 | 0
34 | 0
51 | 0
68 | 0
85 | 3
102 | 5
119 | 7
136 | 9
153 | 11
170 | 12
187 | 15
204 | 16
221 | 19
238 | 21
255 | 23
255 | 22
238 | 21
221 | 19
204 | 17
187 | 15
170 | 13
153 | 11
136 | 9
119 | 8
102 | 6
85 | 4
68 | 2
51 | 0
34 | 0
17 | 0
0 | 0
