RepRapLtd/FrankTheRobot/Frank 2.0/Experiments/potential-divider-r-values-for-opto.ods

min | max | frac | frac | half way
800 | 900 | 0.782013685239492 | 0.879765395894428 | 0.83088954056696
E12 r
1 | 0.203529411764706 | 4.91329479768786
1.2 | 0.244235294117647 | 5.89595375722543 |  |  | final | a→d
1.5 | 0.305294117647059 | 7.36994219653179 |  |  | 0.829145728643216 | 848
1.8 | 0.366352941176471 | 8.84393063583815
2.2 | 0.447764705882353 | 10.8092485549133 | 0.011217409419419
2.7 | 0.549529411764706 | 13.2658959537572
3.3 | 0.67164705882353 | 16.2138728323699 | 0.001743811923744
3.9 | 0.793764705882353 | 19.1618497109827
4.7 | 0.956588235294118 | 23.0924855491329 | 0.006919503113776
5.6 | 1.13976470588235 | 27.514450867052 | 0.002668681671254
6.8 | 1.384 | 33.4104046242774 | 0.001743811923744
8.2 | 1.66894117647059 | 40.2890173410404
