RepRapLtd/FrankTheRobot/Frank 2.0/Electronics/Frank-2-Pi/Frank-2-Pi.kicad_pcb

## KiCad design Frank 2.0/Electronics/Frank-2-Pi/Frank-2-Pi.kicad_pcb (2024-05-29)

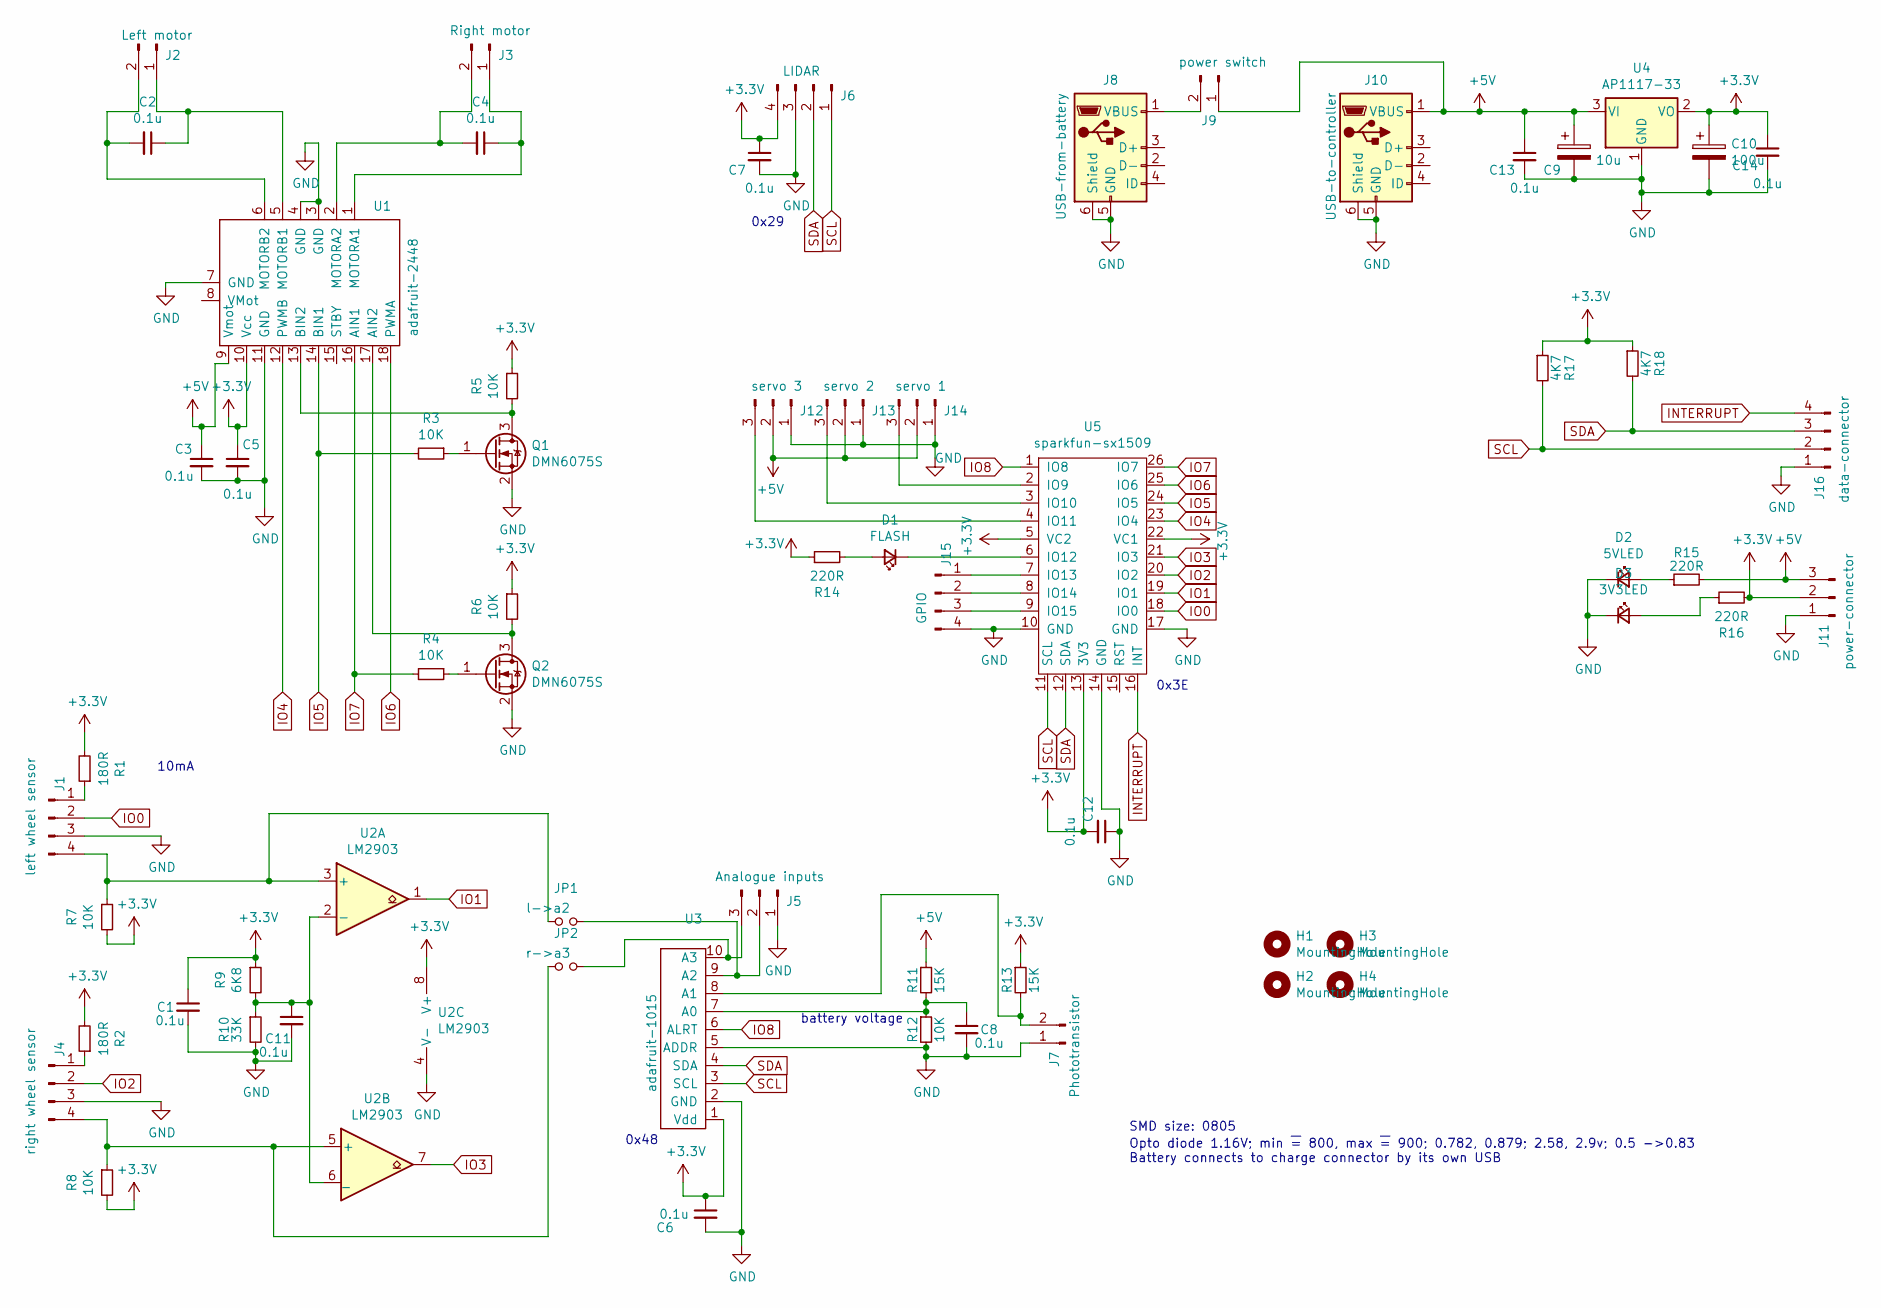
[picture p45: schematic Frank-2-Pi.sch]

Parts:
C1, C2, C3, C4, C5, C6, C7, C8, C11, C12, C13, C14: 0.1u; C_0805_2012Metric
C9: 10u; CP_EIA-3216-18_Kemet-A_Pad1.58x1.35mm_HandSolder
C10: 100u; CP_EIA-3216-18_Kemet-A_Pad1.58x1.35mm_HandSolder
D1: FLASH; LED_D3.0mm
D2: 5VLED; LED_D3.0mm
D3: 3V3LED; LED_D3.0mm
H1, H2, H3, H4: MountingHole; MountingHole_3.2mm_M3
J1: left wheel sensor; PinHeader_1x04_P2.54mm_Vertical
J2: Left motor; PinHeader_1x02_P2.54mm_Vertical
J3: Right motor; PinHeader_1x02_P2.54mm_Vertical
J4: right wheel sensor; PinHeader_1x04_P2.54mm_Vertical
J5: Analogue inputs; PinHeader_1x03_P2.54mm_Vertical
J6: LIDAR; PinHeader_1x04_P2.54mm_Vertical
J7: Phototransistor; PinHeader_1x02_P2.54mm_Vertical
J8: USB-from-battery; USB_Micro-B_Wuerth_629105150521
J9: power switch; PinHeader_1x02_P2.54mm_Vertical
J10: USB-to-controller; USB_Micro-B_Wuerth_629105150521
J11: power-connector; PinHeader_1x03_P2.54mm_Vertical
J12: servo 3; PinHeader_1x03_P2.54mm_Vertical
J13: servo 2; PinHeader_1x03_P2.54mm_Vertical
J14: servo 1; PinHeader_1x03_P2.54mm_Vertical
J15: GPIO; PinHeader_1x04_P2.54mm_Vertical
J16: data-connector; PinHeader_1x04_P2.54mm_Vertical
JP1: l->a2; SolderJumper-2_P1.3mm_Open_RoundedPad1.0x1.5mm
JP2: r->a3; SolderJumper-2_P1.3mm_Open_RoundedPad1.0x1.5mm
Q1, Q2: DMN6075S; SOT-23
R1, R2: 180R; R_0805_2012Metric
R3, R4, R5, R6, R7, R8, R12: 10K; R_0805_2012Metric
R9: 6K8; R_0805_2012Metric
R10: 33K; R_0805_2012Metric
R11, R13: 15K; R_0805_2012Metric
R14, R15, R16: 220R; R_0805_2012Metric
R17, R18: 4K7; R_0805_2012Metric
U1: adafruit-2448
U2: LM2903; Diodes_SO-8EP
U3: adafruit-1015
U4: AP1117-33; SOT-223-3_TabPin2
U5: sparkfun-sx1509

Connections:
+3V3: C1.1, C5.1, C6.1, C7.1, C10.1, C12.2, C14.1, J6.4, J11.2, R1.2, R2.2, R5.1, R6.1, R7.2, R8.2, R9.1, R13.1, R14.1, R16.2, R17.1, R18.1, U1.10 (Vcc), U2.8 (V+), U3.1 (Vdd), U4.2 (VO), U5.5 (VC2), U5.13 (3V3), U5.22 (VC1)
+5V: C3.1, C9.1, C13.1, J9.1, J10.1 (VBUS), J11.3, J12.2, J13.2, J14.2, R11.1, R15.2, U1.9 (Vmot), U4.3 (VI)
GND: C1.2, C3.2, C5.2, C6.2, C7.2, C8.2, C9.2, C10.2, C11.2, C12.1, C13.2, C14.2, D2.1 (K), D3.1 (K), J1.3, J4.3, J5.1, J6.3, J7.1, J8.5 (GND), J8.6 (Shield), J10.5 (GND), J10.6 (Shield), J11.1, J12.1, J13.1, J14.1, J15.4, J16.1, Q1.2 (S), Q2.2 (S), R10.2, R12.2, U1.3 (GND), U1.4 (GND), U1.7 (GND), U1.11 (GND), U2.4 (V-), U3.2 (GND), U3.5 (ADDR), U4.1 (GND), U5.10 (GND), U5.14 (GND), U5.17 (GND)
INTERRUPT: J16.4, U5.16 (INT)
IO0: J1.2, U5.18 (IO0)
IO1: U2.1, U5.19 (IO1)
IO2: J4.2, U5.20 (IO2)
IO3: U2.7, U5.21 (IO3)
IO4: U1.12 (PWMB), U5.23 (IO4)
IO5: R3.2, U1.14 (BIN1), U5.24 (IO5)
IO6: U1.18 (PWMA), U5.25 (IO6)
IO7: R4.2, U1.16 (AIN1), U5.26 (IO7)
IO8: U3.6 (ALRT), U5.1 (IO8)
unnamed: C2.1, J2.1, U1.5 (MOTORB1)
unnamed: C2.2, J2.2, U1.6 (MOTORB2)
unnamed: C4.1, J3.1, U1.1 (MOTORA1)
unnamed: C4.2, J3.2, U1.2 (MOTORA2)
unnamed: C8.1, R11.2, R12.1, U3.7 (A0)
unnamed: C11.1, R9.2, R10.1, U2.2 (-), U2.6 (_)
unnamed: D1.1 (K), U5.6 (IO12)
unnamed: D1.2 (A), R14.2
unnamed: D2.2 (A), R15.1
unnamed: D3.2 (A), R16.1
unnamed: J1.1, R1.1
unnamed: J1.4, JP1.1, R7.1, U2.3 (+)
unnamed: J4.1, R2.1
unnamed: J4.4, JP2.1, R8.1, U2.5 (+)
unnamed: J5.2, JP1.2, U3.9 (A2)
unnamed: J5.3, JP2.2, U3.10 (A3)
unnamed: J7.2, R13.2, U3.8 (A1)
unnamed: J8.1 (VBUS), J9.2
unnamed: J12.3, U5.4 (IO11)
unnamed: J13.3, U5.3 (IO10)
unnamed: J14.3, U5.2 (IO9)
unnamed: J15.1, U5.7 (IO13)
unnamed: J15.2, U5.8 (IO14)
unnamed: J15.3, U5.9 (IO15)
unnamed: Q1.1 (G), R3.1
unnamed: Q1.3 (D), R5.2, U1.13 (BIN2)
unnamed: Q2.1 (G), R4.1
unnamed: Q2.3 (D), R6.2, U1.17 (AIN2)
SCL: J6.1, J16.2, R17.2, U3.3 (SCL), U5.11 (SCL)
SDA: J6.2, J16.3, R18.2, U3.4 (SDA), U5.12 (SDA)

Notes on the sheet:
SMD size: 0805
Opto diode 1.16V; min ~= 800, max ~= 900; 0.782, 0.879; 2.58, 2.9v; 0.5 ->0.83 Battery connects to charge connector by its own USB
10mA
battery voltage
0x29
0x3E
0x48

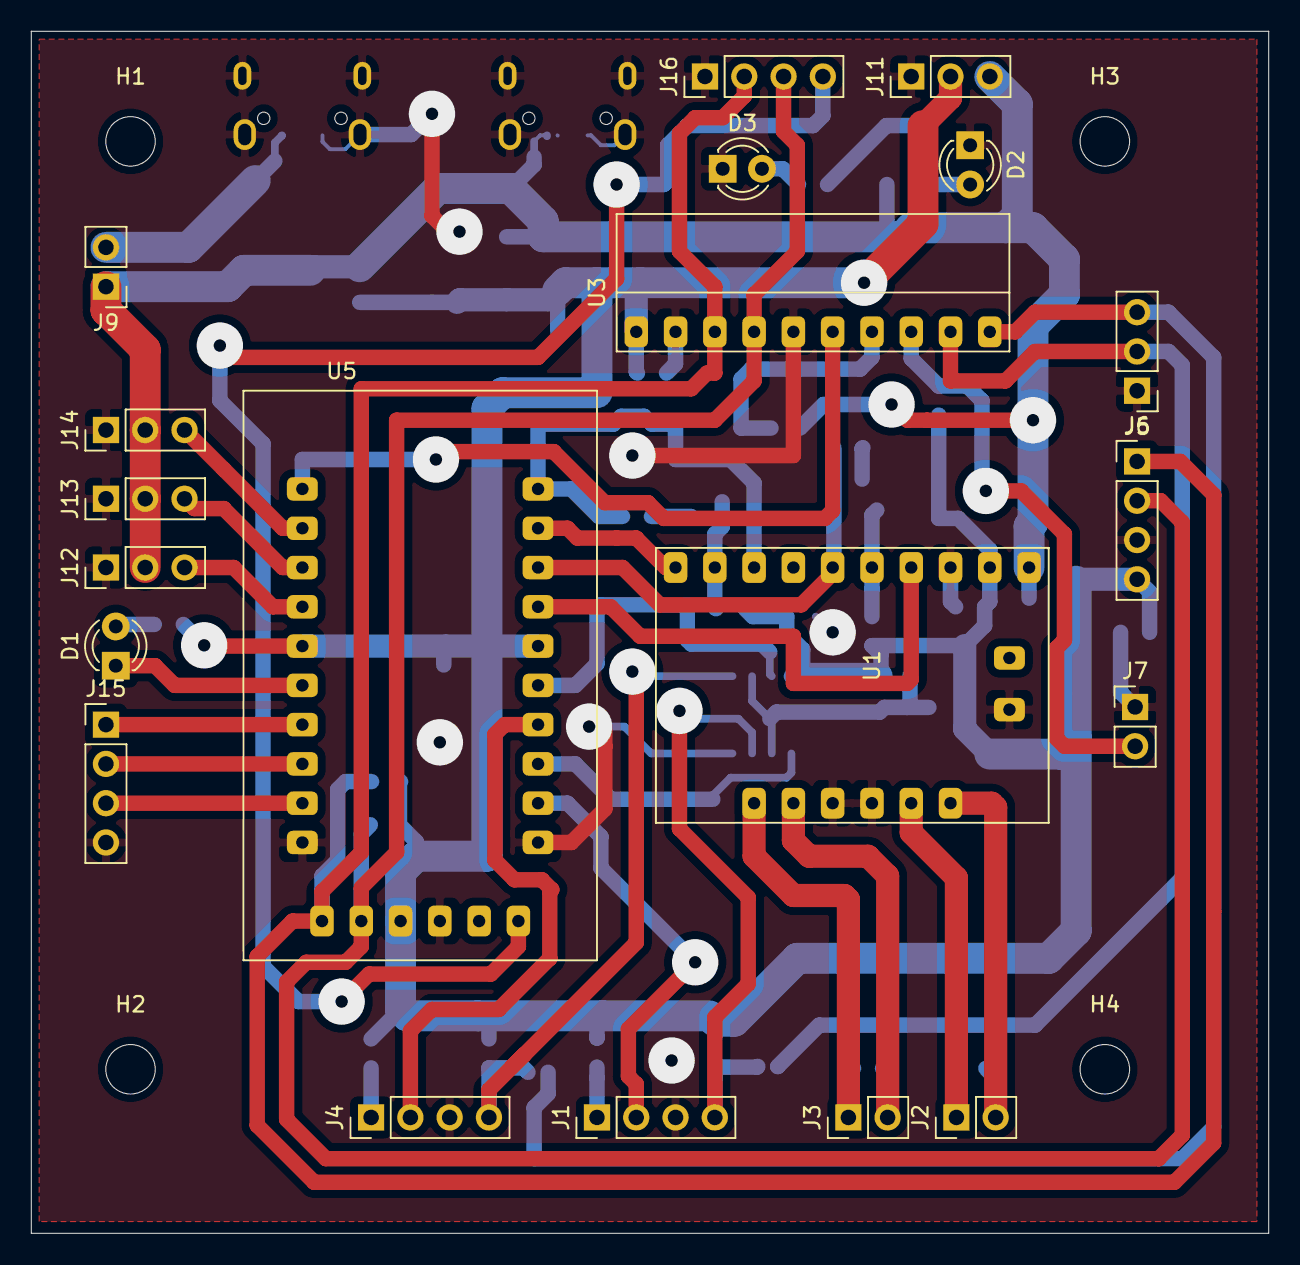
[picture p46: board Frank-2-Pi.kicad_pcb from above]

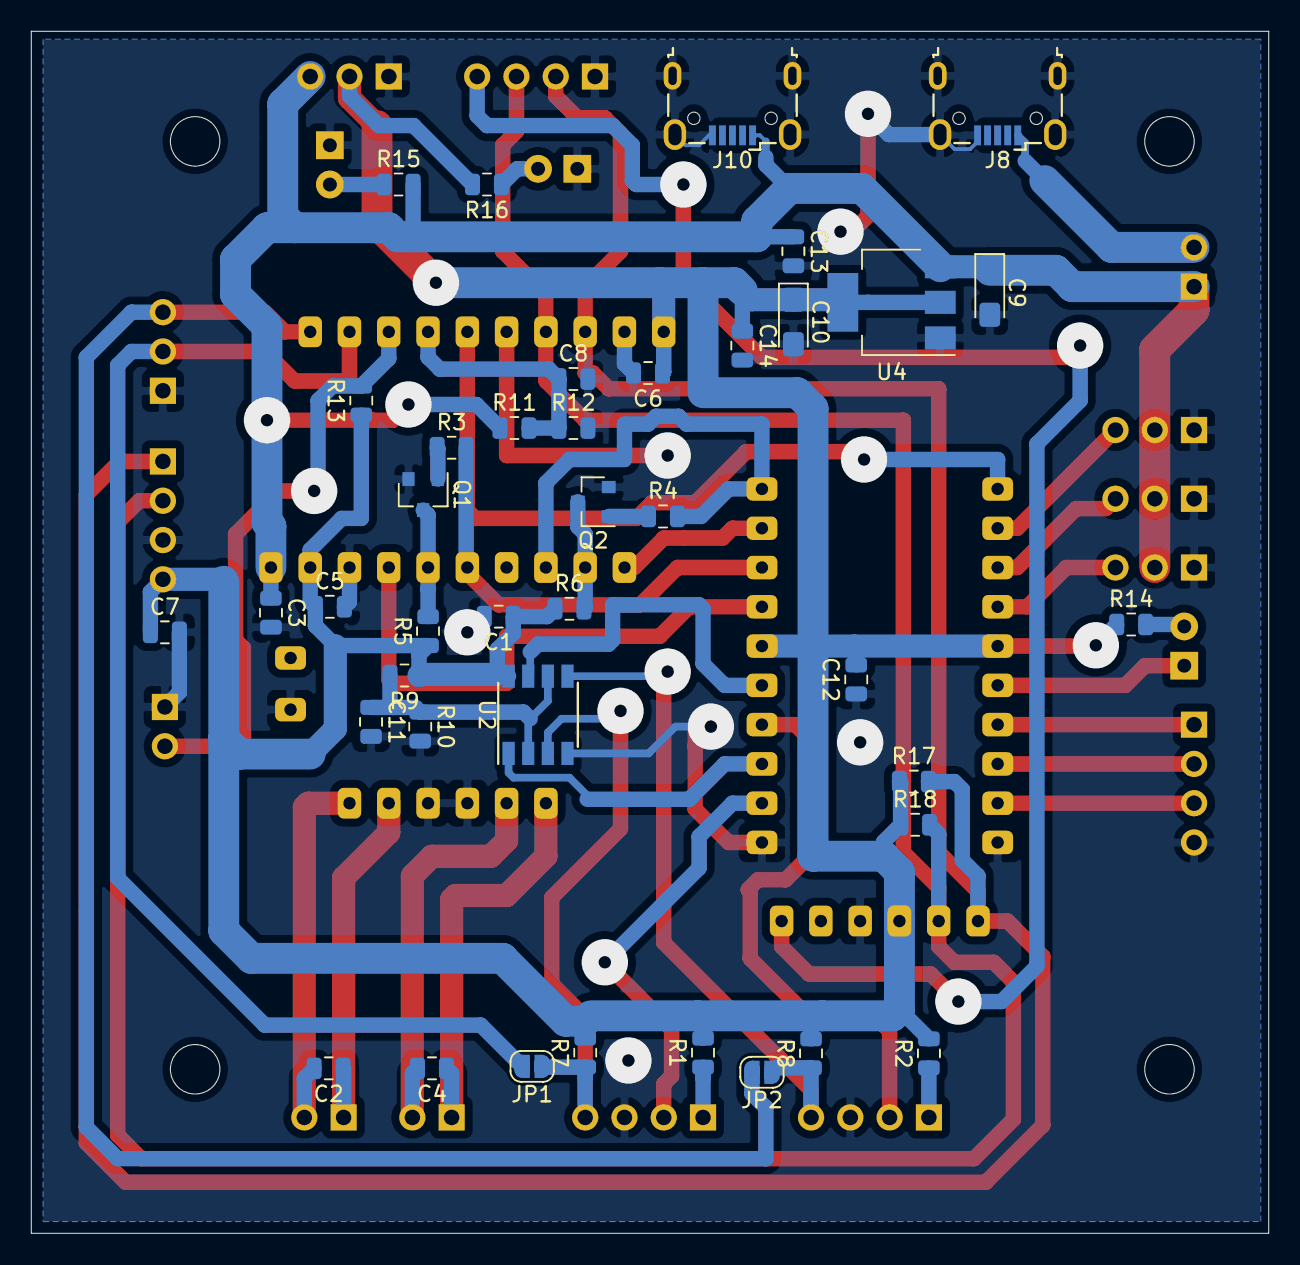
[picture p47: board Frank-2-Pi.kicad_pcb from below]

Board: 2 copper layers, 80.0 x 77.7 mm, 64 parts (40 on the bottom side), 43 nets.
