RepRapLtd/FrankTheRobot/Electronics/frankShield.brd

## EAGLE design Electronics/frankShield.brd (2018-06-20)

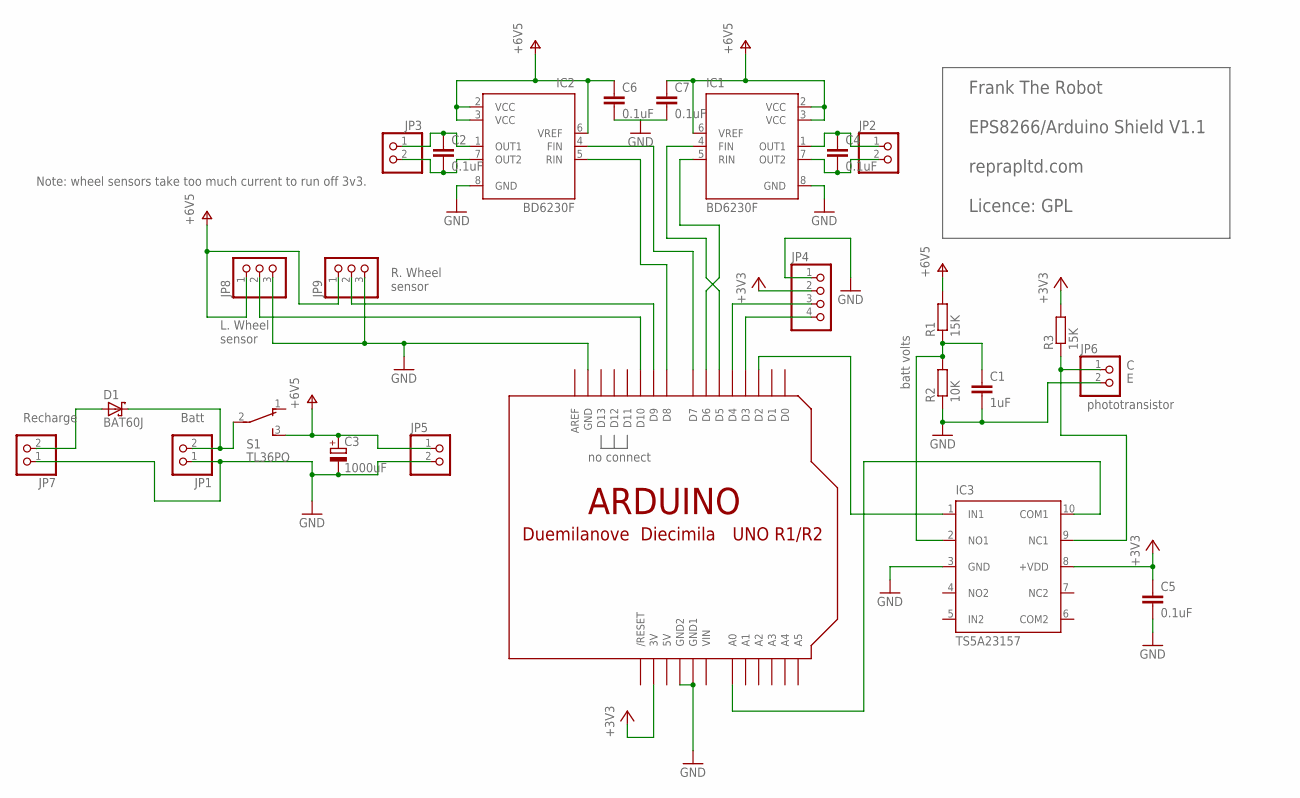
[picture p48: schematic frankShield.sch]

Parts:
C1: 1uF; C0805
C2, C4, C5, C6, C7: 0.1uF; C0805
C3: 1000uF; B45181B
D1: BAT60J; SOD323_ST
IC1, IC2: BD6230F; SOP8
IC3: TS5A23157; MSOP10
JP1, JP2, JP3, JP5, JP6, JP7: PINHD-1X2; 1X02
JP4: PINHD-1X4; 1X04
JP8, JP9: PINHD-1X3; 1X03
R1, R3: 15K; M0805
R2: 10K; M0805
S1: TL36PO; TL3XPO
U$1: ARDUINO-BPLACE

Connections:
5V: U$1.5V
+3V3: C5.1, IC3.8 (+VDD), JP4.2, R3.2, U$1.3V
GND: C1.2, C3.-, C5.2, C6.2, C7.2, IC1.8 (GND), IC2.8 (GND), IC3.3 (GND), JP1.1, JP4.1, JP5.2, JP6.2, JP7.1, JP8.3, JP9.3, R2.1, U$1.GND, U$1.GND1, U$1.GND2
unnamed: JP4.4, U$1.D3
unnamed: JP4.3, U$1.D4
unnamed: C2.1, IC2.1 (OUT1), JP3.1
unnamed: C2.2, IC2.7 (OUT2), JP3.2
unnamed: C4.1, IC1.1 (OUT1), JP2.1
unnamed: C4.2, IC1.7 (OUT2), JP2.2
unnamed: IC1.5 (RIN), U$1.D6
unnamed: IC1.4 (FIN), U$1.D5
unnamed: IC2.4 (FIN), U$1.D7
unnamed: IC2.5 (RIN), U$1.D8
unnamed: IC3.10 (COM1), U$1.A0
unnamed: C1.1, IC3.2 (NO1), R1.1, R2.2
unnamed: D1.C, JP1.2, S1.2
unnamed: IC3.9 (NC1), JP6.1, R3.1
unnamed: IC3.1 (IN1), U$1.D2
unnamed: D1.A, JP7.2
unnamed: JP9.2, U$1.D9
unnamed: JP8.2, U$1.D10
NC2: IC3.7 (NC2)
V+: C3.+, C6.1, C7.1, IC1.2 (VCC), IC1.3 (VCC), IC1.6 (VREF), IC2.2 (VCC), IC2.3 (VCC), IC2.6 (VREF), JP5.1, JP8.1, JP9.1, R1.2, S1.3 (S)
VIN: U$1.VIN

Notes on the sheet:
phototransistor
Frank The Robot EPS8266/Arduino Shield V1.1 reprapltd.com Licence: GPL
Batt
Recharge
L. Wheel sensor
R. Wheel sensor
batt volts
Note: wheel sensors take too much current to run off 3v3.
no connect

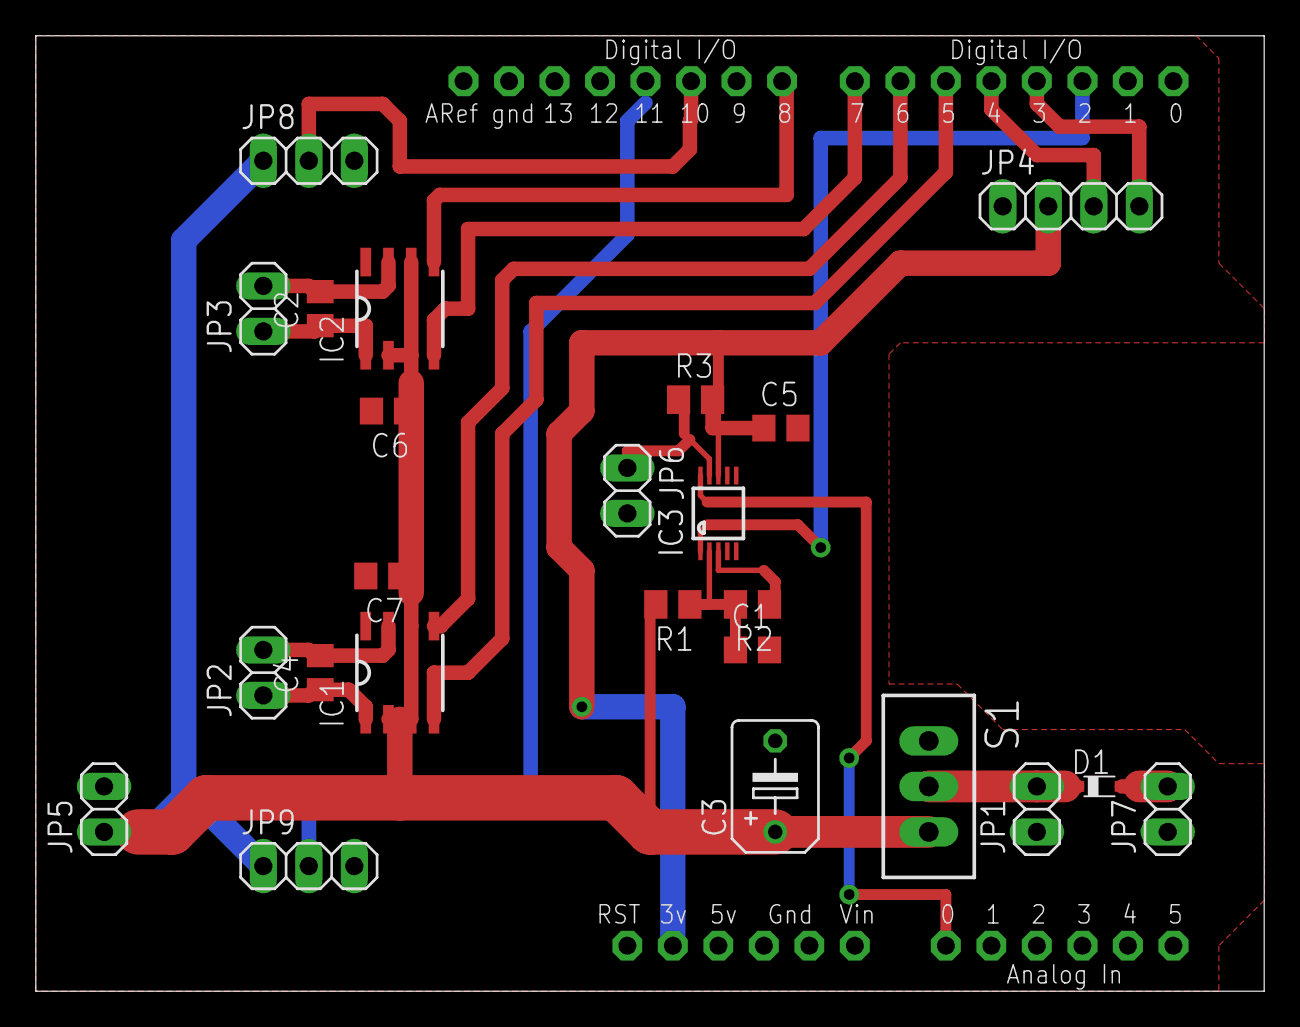
[picture p49: board Electronics/frankShield.brd from above]

Board: 2 copper layers, 68.6 x 53.3 mm, 25 parts (0 on the bottom side), 21 nets.
