RepRapLtd/FrankTheRobot/Legacy/ABs-old-frank-stuff/Electronics/frankShield.brd

## EAGLE design Legacy/ABs-old-frank-stuff/Electronics/frankShield.brd (2017-12-18, an earlier design)

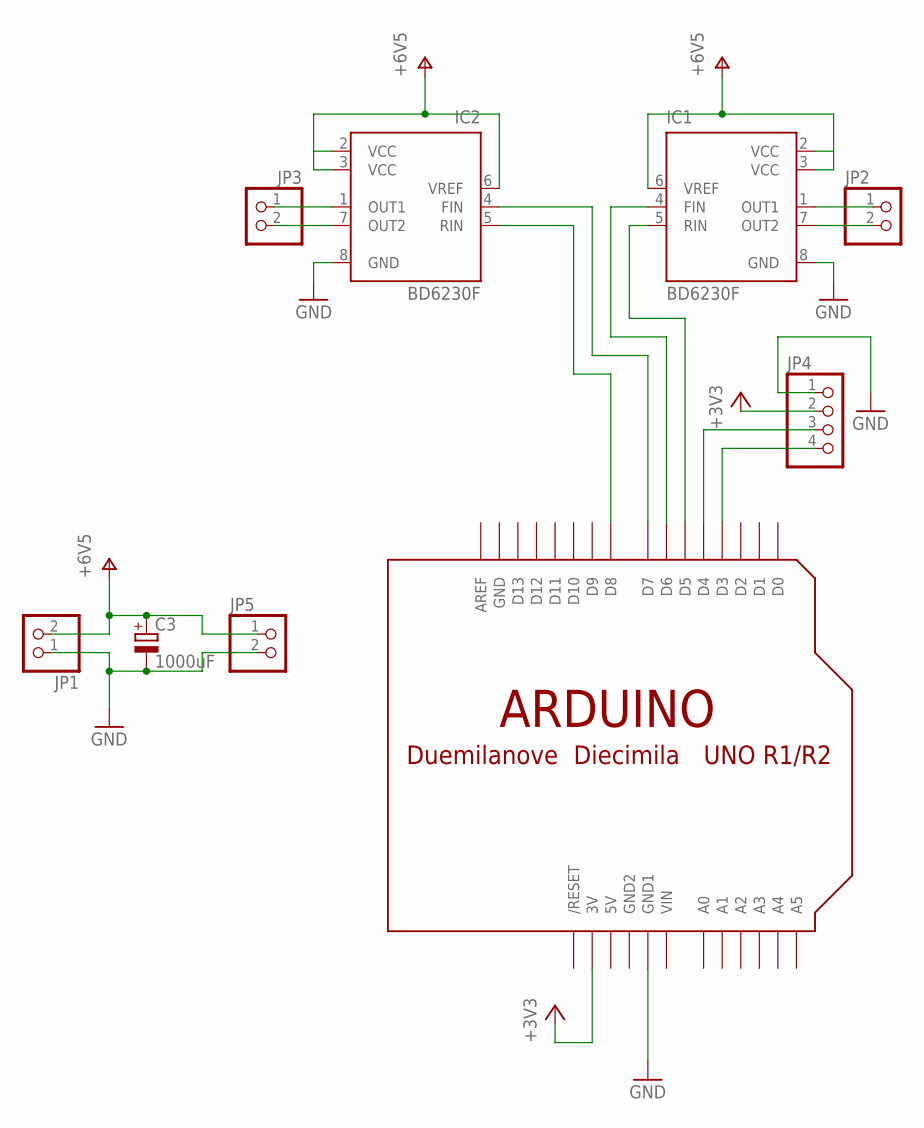
[picture p54: schematic frankShield.sch]

Parts:
C3: 1000uF; B45181B
IC1, IC2: BD6230F; SOP8
JP1, JP2, JP3, JP5: PINHD-1X2; 1X02
JP4: PINHD-1X4; 1X04
U$1: ARDUINO-BPLACE

Connections:
5V: U$1.5V
+3V3: JP4.2, U$1.3V
GND: C3.-, IC1.8 (GND), IC2.8 (GND), JP1.1, JP4.1, JP5.2, U$1.GND, U$1.GND1
GND2: U$1.GND2
unnamed: JP4.4, U$1.D3
unnamed: JP4.3, U$1.D4
unnamed: IC1.1 (OUT1), JP2.1
unnamed: IC1.7 (OUT2), JP2.2
unnamed: IC2.1 (OUT1), JP3.1
unnamed: IC2.7 (OUT2), JP3.2
unnamed: IC1.5 (RIN), U$1.D5
unnamed: IC1.4 (FIN), U$1.D6
unnamed: IC2.4 (FIN), U$1.D7
unnamed: IC2.5 (RIN), U$1.D8
V+: C3.+, IC1.2 (VCC), IC1.3 (VCC), IC1.6 (VREF), IC2.2 (VCC), IC2.3 (VCC), IC2.6 (VREF), JP1.2, JP5.1
VIN: U$1.VIN

Board: 2 copper layers, 9 parts (0 on the bottom side), 13 nets, no tracks yet.
