RepRapLtd/FrankTheRobot/Electronics/wheel-opto-sensor-v2.brd

## EAGLE design Electronics/wheel-opto-sensor-v2.brd (2018-05-11)

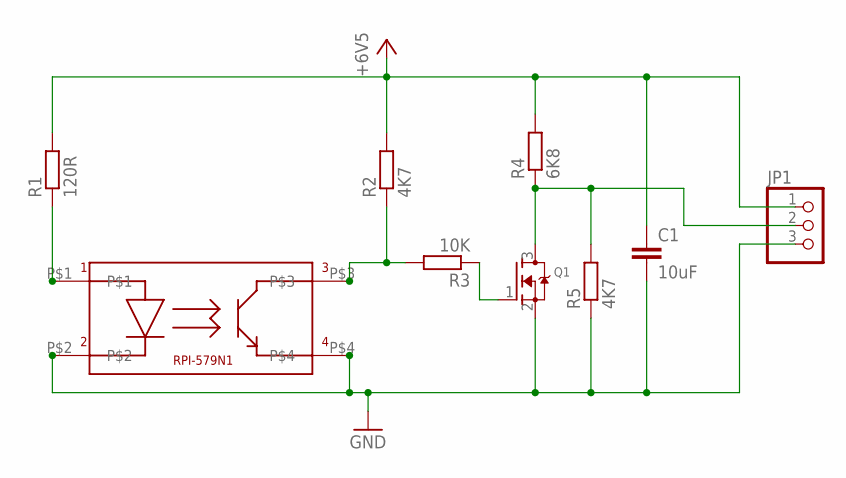
[picture p55: schematic wheel-opto-sensor-v2.sch]

Parts:
C1: 10uF; C1206
JP1: PINHD-1X3; 1X03
Q1: MOSFET-NREFLOW; SOT23
R1: 120R; M0805
R2, R5: 4K7; M0805
R3: 10K; M0805
R4: 6K8; M0805
U$1: RPI-579N1

Connections:
+6V5: C1.1, JP1.1, R1.2, R2.2, R4.2
GND: C1.2, JP1.3, Q1.2 (S), R5.1, U$1.P$2, U$1.P$4
unnamed: JP1.2, Q1.3 (D), R4.1, R5.2
unnamed: R1.1, U$1.P$1
unnamed: Q1.1 (G), R3.1
unnamed: R2.1, R3.2, U$1.P$3

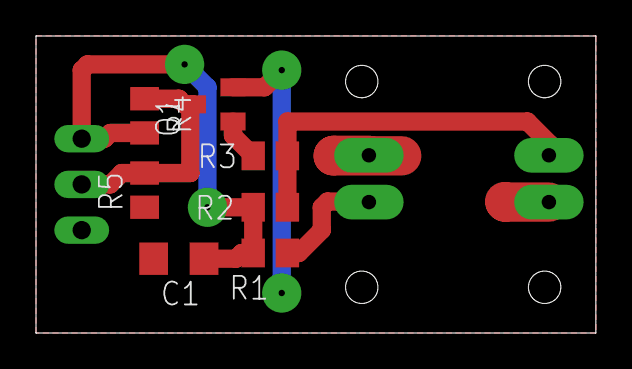
[picture p56: board wheel-opto-sensor-v2.brd from above]

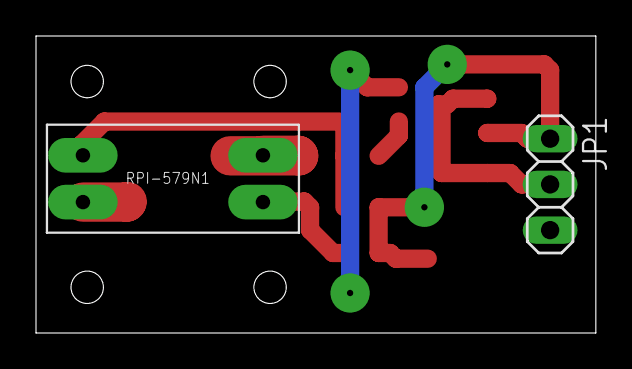
[picture p57: board wheel-opto-sensor-v2.brd from below]

Board: 2 copper layers, 31.1 x 16.5 mm, 9 parts (2 on the bottom side), 6 nets.
