RepRapLtd/FrankTheRobot/Electronics/wheel-opto-sensor.brd

## EAGLE design Electronics/wheel-opto-sensor.brd (2018-01-31, an earlier design)

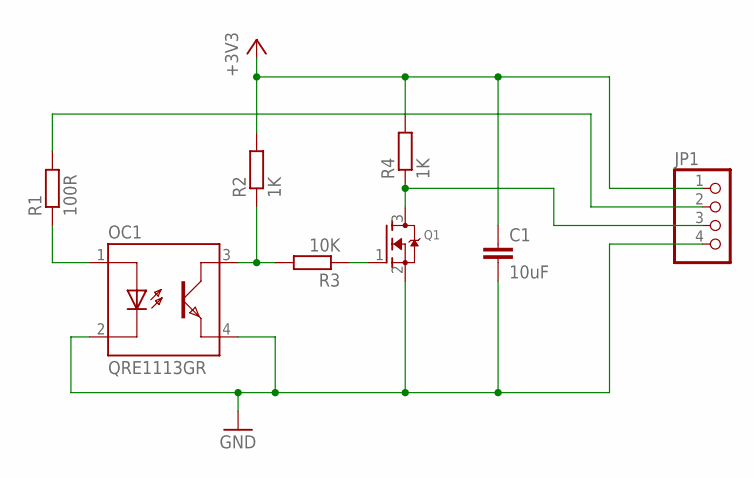
[picture p58: schematic wheel-opto-sensor.sch]

Parts:
C1: 10uF; C1206
JP1: PINHD-1X4; 1X04
OC1: QRE1113GR; SMT_GULLWING_4
Q1: MOSFET-NREFLOW; SOT23
R1: 100R; M0805
R2, R4: 1K; M0805
R3: 10K; M0805

Connections:
+3V3: C1.1, JP1.1, R2.2, R4.2
GND: C1.2, JP1.4, OC1.2 (C), OC1.4 (TE), Q1.2 (S)
unnamed: JP1.3, Q1.3 (D), R4.1
unnamed: OC1.1 (A), R1.1
unnamed: JP1.2, R1.2
unnamed: Q1.1 (G), R3.1
unnamed: OC1.3 (TC), R2.1, R3.2

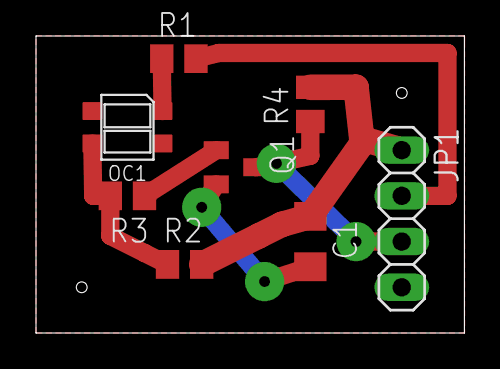
[picture p59: board wheel-opto-sensor.brd from above]

Board: 2 copper layers, 23.8 x 16.5 mm, 8 parts (0 on the bottom side), 7 nets.
