RepRapLtd/FrankTheRobot/(commit log)

2017-12-19 1st hack at the shield design for WiFi Frank...
    [frankShield.brd, frankShield.sch]
2017-12-21 Improved shield design. GERBER files added.
    [I2C-LLC Mk 01.brd, I2C-LLC Mk 01.sch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]
2018-01-08 Added Frank's picture...
    Also Sally w.i.p. on the WiFi version.
    [5028.2 Frank the Robot.fcstd]
2018-01-31 Updated electronics to power the wheel sensors directly off the battery. (They take too much current from 3V3 if that is used; the sensors now have potential dividers so their output never exceeds 3v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
    Added a PCB test program for the Wemos D1/ESP8266 board (W.I.P.)
    [5028.2 Frank the Robot.fcstd, 5028.2 Wheel.g, 5028.2 Wheel.stl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]
2018-02-01 Increased diameter of optosensor vias to make them easier to mill.
    [wheel-opto-sensor-v2.brd]
2018-02-01 Added LED to shield, and anti-short safety diode to the charge circuit.
    [5028.2 Blank Frank the Robot.fcstd, 5028.2 Frank the Robot.fcstd, 5028.2 Main body.stl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]
2018-05-11 PCBs corrected (D9 now LED) and improved (wheel sensor has 4 mounting holes); software updated to match.
    [5028.1 Switch Bracket.stl, 5028.3 Frank the Robot.fcstd, 5028.3 Switch mount.stl, 5028.4 Blank Frank.fcstd, 5028.4 Frank Main Body.stl, 5028.4 Frank.fcstd, 5028.5 Blank Frank.fcstd, I2C-LLC Mk 01.brd]
2018-06-08 PCB test program updated; all works.
    TODO: write motor callibration function
    update schematic and PCB to take account of the use of the
    LED pin for input
    [5028.6 Blank Frank.fcstd, 5028.6 Body.stl, 5028.6 Frank.fcstd, 5028.6 Sensor Mount.stl, 5028.6 Wheel Mount Mirror.stl, 5028.6 Wheel Mount.stl, 5028.6 printed washer.stl, frankShield.sch]
2018-06-20 Wemos MINI PCB added. Corrections to battery holder W.I.P.
    [5028.7 Batt Holder.g, 5028.7 Batt Holder.stl, 5028.7 Blank Frank.fcstd, 5028.7 lidar mount.amf, 5028.7 mount.g, 5028.7 mount.stl, frankShield-v2.brd, frankShield-v2.sch]
2018-06-24 Sally's design mods.
    [5028.7 Blank Frank.fcstd, 5028.7 Body.stl, 5028.7 Frank.fcstd]
2019-01-25 Added phototransistor 665-5347 to schematic.
    [5028.7 Body.stl, 5028.7 Chamfer Wheel.stl, 5028.7 Chamfer Wheel0.75 .stl, 5028.7 Frank.fcstd, 5028.7 Motor Mount.stl, 5028.7 Wheel Sensor Mount.stl, 5028.7 lidar mount.amf, frankShield-v2.sch]
2019-01-30 File tidying.
    [5028.1 Switch Bracket.stl, 5028.2 Main body.stl, 5028.2 Wheel.g, 5028.2 Wheel.stl, 5028.3 Switch mount.stl, 5028.4 Frank Main Body.stl, 5028.6 Body.stl, 5028.6 Sensor Mount.stl]
2020-05-19 Starting work on Frank 2.0.
    Shaft opto encoder and motor/voltage speed experiment.
    [5028.7 Frank.fcstd, 5029.8 Frank Power Dock .fcstd, 5029.8 Power Dock Mount.stl, Wheel 0.1.FCStd, Wheel1.57 2019.stl, frankShield-v2.sch, wheel 0.1.g, wheel 0.1.stl]
2020-05-20 Electronics for Frank 2.0 WIP.
    [Frank-2-Pi.kicad_pcb, Frank-2-Pi.sch]
2020-05-21 Frank 2 electronics WIP.
    [Frank-2-Pi.sch, potential-divider-r-values-for-opto.ods]
2020-05-22 Frank 2.0 electronics WIP.
    [Frank-2-Pi.kicad_pcb, Frank-2-Pi.sch]
2020-05-22 Now with indicator LEDs...
    [Frank-2-Pi.csv, Frank-2-Pi.kicad_pcb, Frank-2-Pi.ods, Frank-2-Pi.sch]
2020-05-25 Electronics WIP
    [Frank-2-Pi.kicad_pcb, Frank-2-Pi.sch]
2020-05-26 PCB WIP
    [Frank-2-Pi.kicad_pcb, Frank-2-Pi.sch]
2020-05-27 PCB finished (but probably not final...) Except for silks
    [Frank-2-Pi.kicad_pcb, Frank-2-Pi.sch]
2020-07-03 Updating lots of Frank 2.0 stuff...
    [Bearing Mount End 0.1.stl, Frank-2-Pi.kicad_pcb, Motor and Opto Sensor Mount 0.1.stl, Motor and Opto Sensor Mount0.1.FCStd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]
2020-07-30 Improved motor mount and sensor. Improved motor test program.
    [#wheel-profile-2.dxf, Bearing Mount End 0.2.stl, Motor and Opto Sensor Mount 0.2.stl, Motor and Opto Sensor Mount 0.3.stl, Motor and Opto Sensor Mount 0.4.stl, Motor and Opto Sensor Mount0.2.FCStd, Motor and Opto Sensor Mount0.3.FCStd, Motor and Opto Sensor Mount0.4.FCStd]
2020-07-31 Improved motor test program WIP.
    [Castor 0.1.FCStd]
2020-08-03 Improved motor test program now working.
    [#wheel-profile-2.dxf, Castor 0.1.FCStd, Motor and Opto Sensor Mount0.5.FCStd, wheel-profile-3.dxf]
2020-08-12 Motor and castor design improvements. I2C pullup resistors added.
    [Bearing Mount End 0.5.stl, Castor 0.1.FCStd, Castor 0.1.g, Castor 0.1.stl, Castor 0.2 and 0.3.g, Castor 0.2.FCStd, Castor 0.2.stl, Castor 0.3.FCStd]
2020-09-02 Updated s/w and PCB
    [Frank-2-Pi.csv, Frank-2-Pi.kicad_pcb, Frank-2-Pi.ods, Motor and Opto Sensor Mount0.5.FCStd, Square Peg 0.3.stl]
2021-03-25 PCB as prototyped.
    [Battery Charge Indicator Clip.FCStd, Frank-2-Pi.kicad_pcb, Frank-2-Pi.sch]
